Hoernchen20/picocell-gw/sketch.md

# Low-cost LoRaWAN gateway: WM1302 (SPI) + W5500-EVB-Pico2

Design sketch for a microcontroller-based LoRaWAN gateway that connects directly to
ChirpStack over MQTT/TLS with protobuf payloads. Firmware in Rust.

Status: concept. WM1302 mPCIe pinout verified against the Seeed WM1302 (SPI) EU868
datasheet (section 2.5); do not copy pin numbers from Seeed's Raspberry Pi
`reset_lgw.sh` scripts (known to be inconsistent, and they describe the Pi HAT, not
the module).

---

## 1. Goals and scope

- Class A uplink/downlink, Class C unicast and Class C multicast (scheduling type
  **Delay**). No Class B for now.
- EU868, single WM1302 SPI module (SX1302 + 2x SX1250), variant **without** the SX1262
  (LBT/spectral scan): LBT is not required in EU868 (ETSI duty cycle applies).
- Ethernet only (W5500). No PoE in the first board revision.
- Power: 24 V DC like an industrial PLC (IEC 61131-2 range 19.2–30 V), wide-input
  front end (9–32 V) so 12 V supplies also work. USB power alone runs the whole board
  (incl. WM1302) for provisioning on the desk.
- Direct connection to ChirpStack's MQTT broker, replacing what Concentratord +
  ChirpStack MQTT Forwarder do on a Linux gateway.
- MQTT authentication: per-gateway username/password, TLS with CA certificate only
  (no client certificate).

---

## 2. Hardware

### 2.1 Components

| Part | Purpose | Notes |
|---|---|---|
| W5500-EVB-Pico2 | MCU (RP2350, 520 KB SRAM, 2 MB flash) + Ethernet | GP16–GP21 are used internally for the W5500 |
| Seeed WM1302 SPI (EU868) | LoRa concentrator, mPCIe 52-pin | SX1302 reset is active HIGH on the SPI version |
| mPCIe socket + standoff/latch | Holds the WM1302 | 52-pin, 0.8 mm pitch |
| Wide-input buck 24 V → 5 V, ≥ 1.5 A | Primary supply (input 9–32 V) | TI LMR38020SDDAR (4.2–80 V, 85 V abs. max, 2 A, HSOIC-8, PFM + spread spectrum), 80 V for surge margin (see 2.4) |
| Input protection | Reverse polarity, surge, overcurrent | PTC 60 V + TVS SM8S33A (6600 W, DO-218AB) as crowbar + series Schottky 100 V, π-filter (see 2.4) |
| 5 V → 3.3 V buck, ≥ 1 A, with EN | Dedicated supply for the WM1302, switched by POWER_EN | TI TPS563201 (3 A, 4.5–17 V, EN with internal pull-down) |
| 5 V → 3.3 V LDO, high PSRR, fast discharge | Supply for the L76K | TI TLV75533PDBVR (500 mA, active output discharge); Quectel advises against a DC-DC here |
| Bulk + ceramic caps | TX current peaks | Limited by the TPS563201 (20–68 µF total output capacitance, see 2.4) |
| Power mux | 5 V from the 24 V buck (priority) or USB VBUS → 5V_SYS | TI TPS2116 (1.6–5.5 V, 2.5 A, 40 mΩ, reverse blocking, ST flag); replaces the VSYS Schottky (see 2.4) |
| ATECC608B (DNP footprint) | Future: mTLS private key in hardware | Same I2C bus as the WM1302 temp sensor, powered from the WM1302 3.3 V rail |
| Quectel L76K (DNP footprint) | Future: Class B / GPS time | GPS/BeiDou/GLONASS/QZSS, 2.7–3.4 V, ~29 mA, UART + 1PPS, U.FL for GNSS antenna |
| PPS buffer (DNP) | L76K 1PPS → WM1302 pin 19 without back-powering | SN74LVC1G17 (Schmitt buffer, I_off), powered from the WM1302 3.3 V rail |
| Status LED | One LED, states as blink patterns | GPIO-driven, visible from outside (light pipe) |
| Buttons | Provisioning (GPIO) and reset (Pico RUN) | Tactile switches |
| 24 V DC input | Pluggable screw terminal (5.08 mm), 3-pin: +24 V, 0 V, FE | USB-C on the Pico for console/flashing/desk power |

### 2.2 Block diagram (signals and power)

```mermaid
flowchart LR
    subgraph PWR["Power"]
        VIN["24 V DC input<br/>(3-pin terminal, FE)"]
        PROT["PTC + TVS (crowbar)<br/>+ Schottky + π-filter"]
        BUCK24["Buck 24V→5V<br/>≥2 A"]
        MUX["Power mux TPS2116<br/>VIN1 priority"]
        V5["5V_SYS rail"]
        BUCK["Buck 5V→3.3V<br/>≥1 A, EN<br/>+ bulk caps"]
        LDO["LDO 5V→3.3V<br/>(GNSS)"]
    end

    subgraph PICO["W5500-EVB-Pico2"]
        VSYS["VSYS"]
        VBUS["VBUS"]
        RUN["RUN"]
        RP["RP2350"]
        W5500["W5500<br/>(GP16–21 internal)"]
        USB["USB-C<br/>console / UF2"]
        RJ45["RJ45"]
    end

    PPSBUF["PPS buffer<br/>(DNP, WM1302 rail)"]
    LED["Status LED"]
    BTN["Provisioning button"]
    RST["Reset button"]

    subgraph WM["WM1302 SPI (mPCIe)"]
        V33["3V3 pins"]
        SX1302["SX1302<br/>+ 2× SX1250"]
        TEMP["Temp sensor (I2C)"]
        PPS["1PPS (pin 19)"]
    end

    ATECC["ATECC608B<br/>(DNP)"]
    GPS["Quectel L76K GNSS<br/>(DNP)"]
    ANT["LoRa antenna (U.FL)"]
    NET["LAN → MQTT broker<br/>(ChirpStack)"]

    VIN --> PROT --> BUCK24 -- "VIN1" --> MUX --> V5
    USB --> VBUS -- "VIN2" --> MUX
    MUX -- "ST" --> RP
    V5 --> BUCK --> V33
    V5 --> VSYS
    V5 --> LDO --> GPS

    RP -- "SPI1: SCK GP10 / MOSI GP11 / MISO GP12" --> SX1302
    RP -- "CS GP13" --> SX1302
    RP -- "SX1302_RESET GP14" --> SX1302
    RP -- "POWER_EN GP15 (buck EN)" --> BUCK
    RP -- "I2C0: SDA GP4 / SCL GP5" --> TEMP
    RP -- "I2C0" --> ATECC
    GPS -- "1PPS" --> PPSBUF --> PPS
    GPS -- "1PPS (GP2)" --> RP
    GPS -- "UART0: GP0/GP1" --> RP
    RP -- "GP28" --> LED
    BTN -- "GP22" --> RP
    RST --> RUN
    SX1302 --- ANT
    RP <--> W5500 --- RJ45 --- NET
    RP --- USB
```

Ground: single common ground between input, buck, Pico and mPCIe socket, tied to the
FE terminal (see 2.4).

### 2.3 Pin map

| Pico GPIO | Function | Peripheral pin |
|---|---|---|
| GP10 | SPI1 SCK | WM1302 pin 45 SPI_SCK |
| GP11 | SPI1 TX (MOSI) | WM1302 pin 49 SPI_MOSI |
| GP12 | SPI1 RX (MISO) | WM1302 pin 47 SPI_MISO |
| GP13 | CS SX1302 | WM1302 pin 51 SX1302_CSN |
| GP14 | SX1302_RESET (active high on SPI version), external pull-down | WM1302 pin 22 RESET |
| GP15 | POWER_EN | EN of the WM1302 3.3 V buck (external pull-down, module off at boot) |
| GP4 / GP5 | I2C0 SDA / SCL | WM1302 pins 32 / 30 (temp sensor), ATECC608B (DNP); 4.7 kΩ pull-ups to the WM1302 3.3 V rail |
| GP0 / GP1 | UART0 TX / RX | L76K pin 3 RXD / pin 2 TXD (DNP) |
| GP2 | PPS sense (input) | L76K pin 4 1PPS (DNP), taken before the PPS buffer |
| GP3 | L76K reset (open-drain: drive low or hi-Z) | L76K pin 9 RESET_N (DNP) |
| GP22 | Provisioning button (input, active low) | Switch to GND, 10 kΩ pull-up to 3V3, 100 nF |
| GP6–GP9 | — | Free |
| GP26 | — | Free (ADC0) |
| GP27 | Power source (input) | TPS2116 ST (open-drain, low = running on USB VBUS), 10 kΩ pull-up to 3V3 |
| GP28 | Status LED (output, active high) | LED + series resistor to GND |
| RUN | Reset button | Switch to GND (RUN has a pull-up on the Pico) |
| GP16–GP21 | — | W5500 (internal, do not use) |

SPI lines from the Pico (SCK, MOSI, CS) get 33 Ω series resistors at the Pico
side (edge damping, limits back-feed into the unpowered module). Pressing reset also
power-cycles the WM1302: GP15 goes hi-Z and the pull-down switches the buck off.

WM1302 mPCIe pins (SPI version, from the Seeed datasheet):

| mPCIe pin | WM1302 signal | Connect to |
|---|---|---|
| 2, 24, 39, 41, 52 | 3V3 | 3.3 V buck output (all five) |
| 4, 9, 15, 18, 21, 26, 27, 29, 34, 35, 37, 40, 43, 50 | GND | Ground plane |
| 19 | 1PPS (input) | L76K 1PPS through the DNP PPS buffer; 100 kΩ pull-down (fitted) so the pin does not float without GNSS |
| 14 / 16 | I2C_SCL / I2C_SDA (temp sensor, second pair) | NC (use 30/32) |
| 36 / 38 | USB_D− / USB_D+ | NC (USB version only) |
| 8, 10, 25, 31, 33 | SX1262 BUSY / RST / CSN / IO2 / IO1 | NC (SX1262 variant not used) |
| others | NC | NC |

The module has **no** power-enable pin; the `SX1302_POWER_EN` in Seeed's scripts
switches a regulator on the Pi HAT. On this board POWER_EN switches the 3.3 V buck.
L76K SET (pin 18) floating = GPS + BeiDou; WAKEUP, ANTON and RESERVED pins NC.

### 2.4 Power notes

- Input: 24 V DC nominal like an industrial PLC; design for 9–32 V continuous so
  IEC 61131-2 (19.2–30 V incl. ripple) and 12 V supplies are covered. Buck rated
  80 V, all parts before the buck (FET, PTC, filter, caps) rated ≥ 100 V.
- Input protection chain: terminal → PTC (60 V, 0.75 A hold) → TVS SM8S33A to GND
  → series Schottky SS210 (100 V, 2 A) → π-filter → LMR38020.
  - The TVS sits directly at the input, before any series element. A reverse-polarity
    blocker in front of a unidirectional TVS (P-FET, diode) would have to block the
    full negative surge (up to −500 V line-to-line), and a bidirectional TVS with the
    SM8S current rating does not exist in SMD.
  - Reverse polarity: the TVS conducts forward (crowbar, ~ −1 V) and the PTC trips;
    it resets once the wiring is fixed. The Schottky keeps the −1 V away from the
    buck (VIN abs. min −0.3 V). Negative surges are clamped the same way.
  - Series Schottky instead of a P-FET / ideal diode: input current is only
    ~0.12 A at 24 V (0.33 A at 9 V), so the drop costs < 0.1 W; one part instead of
    FET + zener + resistor.
  - PTC Imax 100 A covers the short-circuit current of typical 24 V cabinet supplies;
    hold current 0.75 A at 25 °C, ~0.5 A at 85 °C, above the 0.33 A worst case at 9 V.
  - π-filter for conducted EMC: 4.7 µF / 100 V ceramic, 4.7 µH, then 2× 22 µF / 100 V
    electrolytic + 4.7 µF ceramic + 100 nF at the buck. Resonance ≈ 33 kHz, well below
    f_SW = 400 kHz. The electrolytic on the buck side is **mandatory**, see surge
    check below.
- Surge target: EN IEC 61000-6-2:2019 (= IEC 61000-6-2:2016), Table 3 item 3.2,
  DC power port, IEC 61000-4-5, 1.2/50 (8/20) µs, criterion B: **±0.5 kV
  line-to-line, ±1 kV line-to-earth**. IEC 61000-4-5 source impedance on power
  ports: 2 Ω line-to-line (→ 250 A short circuit at 0.5 kV), 12 Ω (10 Ω + 2 Ω)
  line-to-earth (→ 84 A at 1 kV); ST AN4275 Table 2.
- Applicability (Table 3 notes, definitions 3.5, 3.6):
  - Surge only on ports "interfacing with long distance lines": > 30 m inside the
    building or leaving the building (note b). Not for removable/rechargeable
    batteries.
  - DC ports not intended for a "DC distribution network" (site supply for several
    devices; a link to one local battery is not one) are tested as signal ports
    (Table 2: ±1 kV line-to-earth only, 42 Ω, also only for long distance lines;
    no line-to-line test).
  - With a specified AC–DC adaptor the surge goes on the adaptor's AC input
    (notes d, f); not our case.
  - A 24 V cabinet supply feeding several devices counts as a DC distribution
    network, so the board is designed for the full Table 3 levels; with cables
    ≤ 30 m inside the building the test would not apply at all.
- Line-to-earth: the board GND reaches earth through the coax shields (grounded
  mast), the Ethernet shield and the FE terminal. On a +24 V-to-earth surge the
  current flows +24 V → TVS → GND → FE, at most 84 A, below the line-to-line case.
- Earth terminal: 3-pin input terminal +24 V / 0 V / FE. FE is a functional earth,
  not a protective earth (24 V SELV/PELV device, no protective function), so label
  it FE. GND is tied **directly** to FE with wide copper, no capacitor: a GND–FE
  capacitor (e.g. 4.7 nF) cannot carry the 84 A line-to-earth surge. Many cabinets
  earth the 24 V supply's 0 V anyway, so the direct link adds no new ground loop.
  - Miswiring +24 V onto FE shorts the supply across the board's 0 V–FE copper,
    bypassing the PTC. Put the pins in the order +24 V, 0 V, FE, use a coded plug,
    and size the 0 V–FE copper for the supply's short-circuit current until its
    current limit or fuse acts.
- Surge check result: line-to-line the generator source impedance is 2 Ω, so the
  TVS sees up to ~250 A (8/20 µs). SMCJ33A: 155 A at 8/20 µs (Littelfuse product
  page), so it **does not pass**. Its 53.3 V clamp is specified at only 28.2 A
  (10/1000 µs); at 8/20 µs surge currents the clamp is well above that. SM8S33A
  (6600 W, 53.3 V at 124 A 10/1000 µs) carries the current, but its clamp at ~250 A
  is likely at or above 60 V, which would leave a 60 V buck such as the LMR36015
  (60 V operating, 66 V abs. max) no margin.
- Decision: SM8S33A + TI LMR38020 (4.2–80 V, 2 A, HSOIC-8) instead of the LMR36015;
  all parts before the buck rated ≥ 100 V. Rejected: keeping the 60 V buck with a
  two-stage protection (primary TVS, series impedance, secondary TVS); more parts.
- SM8S33A clamp at the real surge current (estimate, Vishay gives only 10/1000 µs
  data): linear model V_C = V_BR + R_d · I with V_BR max 40.6 V and
  R_d = (53.3 − 36.7) V / 124 A = 0.134 Ω (conservative, from V_BR min). Simulated
  with the 0.5 kV / 2 Ω generator, IEC 8/20 short-circuit current, then Schottky,
  4.7 µH, 2 µF effective ceramic (4.7 µF / 100 V at DC bias) and the electrolytic
  (script: TVS + π-filter ODE, no PTC resistance, no wiring inductance; both
  would lower the peaks):

  | Case | I_TVS peak | V_TVS peak | V at LMR38020 VIN |
  |---|---|---|---|
  | 25 °C, 47 µF / 0.5 Ω electrolytic | 200 A | 67 V | 61 V |
  | 85 °C (V_BR +6 %), 2× 22 µF / 100 V | 197 A | 69 V | **63 V** |
  | 85 °C, **no electrolytic** | 213 A | 72 V | **99 V** (LC overshoot) |

  Result: TVS clamp ≤ 72 V, buck input ≤ 63 V with the electrolytic, i.e. 17 V
  below the 80 V operating and 22 V below the 85 V absolute maximum. Without the
  damping electrolytic the π-filter rings above 85 V, so it must be fitted on the
  buck side of the filter inductor and rated 100 V (not 63 V). Peak current through
  the Schottky and the filter inductor ≈ 46 A for some 10 µs (SS210 I_FSM 50 A at
  8.3 ms; the inductor saturates briefly, which lowers L and the overshoot).
  Pulse energy in the TVS ≈ 70 V · 200 A · ~20 µs ≈ 0.3 J, far below its rating.
- LMR38020 values (datasheet SNVSC40E, Table 9-1 and section 9.2.2), 24 V → 5 V,
  400 kHz:
  - f_SW 400 kHz: R_T = 64.9 kΩ (RT/SYNC must not float or be shorted). 2.2 MHz is
    not possible at 32 V in (t_ON = 71 ns < t_ON-MIN 80–131 ns).
  - FB: R_FBT 100 kΩ, R_FBB 24.9 kΩ (V_REF 1.0 V → 5.0 V).
  - L = 15 µH (Eq. 10 with K = 0.4 at 32 V: 13 µH), I_SAT ≥ 3.8 A
    (I_HS-LIMIT max): FCH0650-150M (5 A).
  - C_OUT 3× 22 µF / 25 V X5R 1206 (TI: 3× 22 µF nominal, 2× 22 µF minimum).
  - C_IN: 4.7 µF / 100 V X7R 1210 + 100 nF / 100 V 0603 at the VIN pin (single
    VIN pin, GND = pin 1 + thermal pad), C_BOOT 100 nF.
  - EN: UVLO divider R_ENB 100 kΩ, R_ENT 536 kΩ → on at 8.0 V, off at ~7.0 V
    (V_EN-H 1.25 V, V_EN-L 1.10 V); during a surge EN sees ≤ 11 V (abs. max
    V_IN + 0.3 V).
  - PG unused; route to a test point (the TPS2116 ST on GP27 already tells whether
    the 24 V path is up).
  - Layout: tight C_IN–VIN–GND loop, small SW node, FB divider at FB away from SW,
    thermal vias under the pad; 4-layer board with a solid inner GND plane. No
    snap-back (thyristor) TVS on the input (TI: output caps discharge back into it).
- TPS563201 (5 V → 3.3 V, WM1302), datasheet Table 7-2: R1 33.2 kΩ, R2 10 kΩ,
  L 2.2 µH, **total output capacitance 20–68 µF** (D-CAP2 stability). So no
  2× 100 µF bulk at the socket: 2× 22 µF at the buck + 22 µF + 100 nF at the
  mPCIe 3V3 pins (66 µF nominal, less with DC bias), plus a DNP footprint for a
  polymer bulk cap to try on the real board. EN has an internal 1.5 MΩ pull-down
  (module off while GP15 floats at boot); add 4.7 kΩ external (see RP2350-E9 below).
  Input 10 µF + 100 nF.
- RP2350-E9: on A2 silicon a Bank 0 GPIO with the input buffer enabled leaks and can
  float to ~2 V against a weak pull-down; the erratum asks for external pull-downs
  ≤ 8.2 kΩ. The A4 stepping fixes it, but the stepping on the W5500-EVB-Pico2 is not
  guaranteed, so POWER_EN (GP15) and SX1302_RESET (GP14) get 4.7 kΩ to GND
  (0.7 mA while driven high). Harmless on A4.
- 5V_SYS via power mux: TI TPS2116 in priority mode, VIN1 = LMR38020 output,
  VIN2 = Pico VBUS (pin 40), VOUT = 5V_SYS → Pico VSYS, TPS563201, TLV75533. PR1
  divider from VIN1 sets the switchover: V_REF 0.92–1.08 V (datasheet SLVSFG1A),
  33.2 kΩ / 10 kΩ → 4.32 V nominal, 3.97–4.67 V worst case, below the 5.0 V buck
  output. MODE tied to VIN1; without 24 V MODE is low and the mux passes the higher
  input (VBUS). 1 µF at VIN2, 22 µF at VOUT. The
  mux blocks reverse current, so 5V_SYS never feeds the USB host or the buck output,
  and the SS34 to VSYS is dropped; the Pico's internal VBUS → VSYS Schottky in
  parallel is harmless. A plain Schottky from VBUS would not work: VBUS min 4.75 V
  minus ~0.35 V is below the TPS563201's 4.5 V minimum input. ST (open-drain, low
  when VIN2 is used) → GP27, so firmware knows it runs on USB.
- USB budget: WM1302 max ~0.3 A at 5 V (TX 26 dBm) + Pico/W5500 ~0.15 A ≈ 0.45 A,
  just inside 500 mA. On USB power the firmware limits TX power (or does not
  transmit); provisioning and RX work normally.
- Rails from 5V_SYS: Pico VSYS, 5 V → 3.3 V buck for the WM1302 and 5 V → 3.3 V
  LDO for the L76K.
- Power domains and back-powering: the Pico 3V3 and the L76K LDO are always on,
  the WM1302 rail is switched. Everything that connects to the module is either
  driven by the Pico (kept low/input while the rail is off, 33 Ω series on SPI) or
  sits in the WM1302 domain: I2C pull-ups and the ATECC608B on the WM1302 rail (the
  ATECC is only usable while the module is on, fine since it is only off for a
  power-cycle), 1PPS through a DNP SN74LVC1G17 powered from the WM1302 rail (I_off:
  input and output high-Z while unpowered). Fit the buffer together with the L76K.
- Current budget at 5 V: WM1302 max 415 mA at 3.3 V (datasheet, TX 26 dBm) ≈ 0.3 A,
  Pico 2 + W5500 ≈ 0.15 A, L76K 29 mA. Total ≈ 0.5 A, so the 2 A 24 V → 5 V stage and
  a ≥ 1 A WM1302 buck leave good margin for start-up and TX transients.
- Do **not** power the WM1302 from the Pico's 3V3 pin; use the dedicated buck.
- Place the socket decoupling (22 µF + 100 nF) close to the mPCIe 3.3 V pins for TX peaks.
- Power sequencing: keep all Pico pins towards the WM1302 as inputs / low until the
  module's 3.3 V rail is up (avoid back-powering through I/O). POWER_EN (GP15) drives
  the buck's EN with a pull-down, which also gives a hard power-cycle of the module.
- Status LED on GP28 shows states as blink patterns (e.g. booting, no Ethernet, no
  broker, online, provisioning mode, error).

### 2.5 Parts for JLCPCB assembly

Checked against the JLCPCB parts library on 2026-10-17 (stock changes; re-check
before ordering). "Basic" parts have no extended-part setup fee. DNP parts are not
placed, so they need a footprint but no stock.

| Ref / function | Part | LCSC | Lib | Stock | Notes |
|---|---|---|---|---|---|
| 24 V input terminal | DEGSON 15EDGVC-5.08-03P-14-00AH (3-pin) | to check | ext | — | THT header, +24 V / 0 V / FE; plug 15EDGK-5.08-03P ordered separately (2-pin version was C23107080) |
| PTC | TECHFUSE SMD075L-60V (2920) | C2833621 | ext | 4.3k | 0.75 A hold / 1.5 A trip, 60 V, Imax 100 A |
| TVS | Vishay SM8S33AHE3_A/I (DO-218AB) | C335622 | ext | 4.5k | DOWO C312613 (9k) as second source |
| Series Schottky | MDD SS210 (SMA) | C14996 | basic | 787k | 100 V 2 A |
| π-filter inductor | Sunlord SWPA4030S4R7MT | C57269 | ext | 19k | 4.7 µH |
| 100 V ceramic | FH 1210B475K101NT (4.7 µF X7R 1210) | C2840282 | ext | 31k | 2× (filter in, buck VIN) |
| 100 V 100 nF | Samsung CL10B104KC8NNNC (0603) | C15725 | ext | 133k | at buck VIN |
| Damping electrolytic | Panasonic EEEFK2A220P (22 µF 100 V, D8×10.2) | C178570 | ext | 4.1k | 2× in parallel |
| 24 V → 5 V buck | TI LMR38020SDDAR | C3192337 | ext | 9.3k | |
| 15 µH inductor | FANGCHENG FCH0650-150M | C20415538 | ext | 8.4k | I_SAT 5 A |
| 22 µF 25 V 1206 | Samsung CL31A226KAHNNNE | C12891 | basic | 492k | 5 V out (3×), 3.3 V out |
| 5 V → 3.3 V buck | TI TPS563201DDCR | C116592 | ext | 112k | |
| 2.2 µH inductor | Sunlord SWPA4030S2R2MT | C36409 | ext | 37k | |
| Power mux | TI TPS2116DRLR (SOT-583) | to check | ext | — | VIN1 buck 5 V, VIN2 VBUS; replaces the SS34 |
| PPS buffer (DNP) | TI SN74LVC1G17DBVR (SOT-23-5) | to check | — | — | I_off, powered from the WM1302 rail |
| Status LED | 0603 LED, basic library | to check | basic | — | |
| Buttons | SMD tactile switch, basic library | to check | basic | — | 2× (provisioning, reset) |
| mPCIe socket | XUNPU PCIE-52P52H (5.2 mm) | C266899 | ext | 12k | SOFNG C444927 as second source |
| Module standoff | Würth 9774030243R (M2, 3.0 mm SMT) | C22431109 | ext | 725 | height to check against socket drawing |
| Pico headers | HCTL PM254-1-20-Z-8.5 (1×20 female) | C2897383 | ext | 4.2k | 2×, THT |
| L76K LDO (DNP) | TI TLV75533PDBVR | C404027 | ext | 117k | active discharge, VIN ≤ 5.5 V |
| GNSS (DNP) | Quectel L76KB-A58 | C2916234 | ext | 2.2k | |
| GNSS U.FL (DNP) | BAT WIRELESS BWU.FL-IPEX1 | C5137195 | ext | 595k | |
| GNSS bias L (DNP) | Murata LQG15HS68NJ02D (68 nH 0402) | C98000 | ext | 15k | |
| GNSS RF ESD (DNP) | Nexperia PESD5V0F1BL (0.4 pF) | C45961 | ext | 53k | |
| ATECC608B (DNP) | ATECC608B-SSHDA-T (SOIC-8) | C1518769 | ext | 921 | |
| V_BCKP supercap (DNP) | not stocked at JLCPCB, see section 6 | — | — | — | THT, hand-soldered |

Resistors and small caps (0402/0603) from the basic library. THT parts (terminal,
Pico headers, supercap) either via JLCPCB THT assembly or hand-soldered.
The WM1302 carries its own U.FL for the LoRa antenna; the board needs no LoRa RF
path.

---

## 3. Firmware architecture (Rust)

### 3.1 Stack

| Layer | Choice |
|---|---|
| Runtime / HAL | Embassy, `embassy-rp` (RP2350) |
| Ethernet / IP | `embassy-net-wiznet` (W5500 MACRAW) + `embassy-net` (smoltcp), static IPv4 (DHCP optional), see 3.4 |
| Name resolution | Own resolver: hosts table, then own DNS client over UDP (optional), see 3.4 |
| TLS | `embedded-tls` git `main` pinned to rev `6487c62` (TLS 1.3 only, **not** 0.19.0, see below), features `p256` + `rustpki`; crypto via `embassy-crypto` (git) with `embassy-crypto-rustcrypto`, own RNG driver on the RP2350 TRNG; fail-closed clock wrapper around the verifier |
| MQTT | `rust-mqtt` 0.6 (MQTT 5, no_std, no alloc with `bump` feature) |
| Protobuf | `micropb` (no alloc, heapless containers), generated from ChirpStack `api/proto/gw/gw.proto` + `common.proto` |
| Concentrator | Semtech `sx1302_hal` (C) built via `cc`, with a Rust shim for SPI/I2C/delays. Later optionally ported to Rust |
| Config storage | `sequential-storage` KV in a flash partition, AES-GCM encrypted |
| Bootloader / OTA | RP2350 boot ROM: secure boot + partition table A/B + TBYB, no second-stage bootloader |

Reference implementations: ChirpStack Concentratord and ChirpStack MQTT Forwarder
(both Rust, Linux).

Decisions and reasons:

- **TLS (`embedded-tls`)**: TLS 1.3 only, so the broker must offer TLS 1.3
  (Mosquitto with OpenSSL ≥ 1.1.1 does). The broker certificate uses an
  **ECDSA P-256** key: RSA verification needs the `rsa` crate and a global
  allocator, P-256 does not. RP2350 has a SHA-256 accelerator and TRNG; AES-GCM and
  P-256 run in software (handshake time still to be measured on the RP2350).
  - **Do not use the 0.19.0 release** (checked 2026-10-23): it accepts a server
    `Finished` without `Certificate` / `CertificateVerify`, so an on-path attacker
    completes the handshake with any verifier (upstream issue #215, fixed on `main`
    2026-10-20, not released). Its async record read is also not cancel-safe
    (partial record header lost when a `select!` drops the read, fixed on `main`
    2026-09-09). Pin `main` to a reviewed rev until a release after 0.19.0 exists.
  - Verifier on `main`: `rustpki` (`pki::CertVerifier`) accepts **only a broker
    certificate signed directly by the trusted root** and ignores the rest of the
    chain (a chain through an intermediate needs the `webpki` verifier). So: a
    dedicated P-256 root CA for the broker only, signing the broker certificate
    directly, no intermediate. This also removes the old `basicConstraints` problem
    (0.19.0 accepted a chain signed by an ordinary CA:FALSE leaf) and the
    chain-pinning wrapper. `webpki` on `main` now builds no_std via
    `rustls-webpki` 0.103 + `embassy-crypto` but is not needed.
  - Checks: validity dates, signature by the root, hostname via SAN/CN (max. 3 SANs
    of 64 chars), `CertificateVerify`.
  - If the clock is unknown (`TlsClock::now()` returns `None`), `rustpki` skips the
    validity check; a small wrapper verifier rejects in that case (fail closed, see
    section 6).
  - Crypto on `main` goes through `embassy-crypto` drivers resolved at link time:
    `embassy-crypto-rustcrypto` (SHA-256, HMAC, AES-128-GCM, P-256) plus an RNG
    driver. Released `embassy-rp` 0.10 has no `embassy-crypto-rng` feature (git
    `main` has it), so the firmware registers its own ~15-line driver on the TRNG
    (`embassy_crypto::rng_impl!`). Keep the rest of Embassy on the crates.io
    releases: Embassy git `main` replaced smoltcp in `embassy-net` with a new stack.
  - Record buffers: read buffer 16640 B (one full TLS record), write buffer 4352 B
    (records the device sends are split to fit). `max_fragment_length` (4096) with
    a 4352 B read buffer also works with OpenSSL/Mosquitto, but depends on the
    broker (or a TLS proxy in front of it) honouring the extension; RAM is not
    tight, so the full-size read buffer is used instead. Size: `TlsConnection`
    0.6 KB + verifier (`CERT_SIZE` 2048) 2.6 KB + buffers 20.5 KB ≈ 24 KB.
- **MQTT (`rust-mqtt` 0.6)**: `rumqttc` rejected (needs `std` + `tokio`).
  `rust-mqtt` is MQTT 5 only (fine with Mosquitto ≥ 1.6), uses `embedded-io-async`
  0.7 like `embedded-tls` and `embassy-net` 0.9, and needs no allocator with the
  `bump` feature. Tested 2026-10-23 on the host against Mosquitto 2.0.11 (TLS 1.3,
  P-256 root → broker certificate, password file, ACL from 4.1), all passed:
  - Refused: unknown CA, wrong hostname, unknown time (fail closed), wrong password
    (`NotAuthorized`).
  - Retained `state/conn` ONLINE (QoS 1) and a retained Last Will OFFLINE, which the
    broker publishes when the TCP connection drops without DISCONNECT.
  - Subscribe `command/down` QoS 1; 1 KB and 10 KB downlinks received intact; a
    20 KB downlink above the client's `maximum_packet_size` (12 KB) is not
    delivered by the broker.
  - Uplinks QoS 0 / 1 with PUBACK; publishing to another gateway's topic is
    refused by the ACL (PUBACK `NotAuthorized`).
  - Full duplex in one task: `select!` of `poll_header()` against queued uplinks
    and a ping ticker. 300 × 1.5 KB downlinks during 236 uplinks; with a transport
    that returns 1–3 bytes per read, so most cancellations hit mid-record. With the
    record-header fix removed (0.19.0 behaviour) the same test breaks the
    connection on the first cancelled read.
  - Usage rules from this: only `poll_header()` is cancel-safe, so select on it and
    then run `poll_body()` to completion; never wrap `poll()` in a timeout, use the
    TCP socket timeout instead. Keepalive pings are the application's job.
    `BumpBuffer` needs an `unsafe` `reset()` after each event is dropped. One topic
    per SUBSCRIBE. `abort()` refuses on a healthy connection; drop the transport
    or `disconnect()` instead.
  - Cross-build for the RP2350 (`embassy-rp` 0.10, `embassy-net-wiznet` 0.3,
    `embassy-net` 0.9.1, TLS, MQTT, own TRNG driver, defmt, `opt-level = "s"`,
    LTO): `.text` + `.rodata` 215 KB, `.bss` 68 KB including 25 KB of TCP/TLS/MQTT
    buffers (before the full-size TLS read buffer, +12 KB).
- **Protobuf (`micropb`)**: no allocator in the whole firmware, bounded memory per
  message. `prost` would need `alloc` only for this; rejected. Generation tested
  with `micropb-gen` 0.6 + vendored `protoc` (`protoc-bin-vendored`, no system
  install):
  - Builds no_std for `thumbv8m.main-none-eabihf`. Interop checked both ways: a
    `DownlinkFrame` encoded by `protoc` decodes correctly (2 items, LoRa modulation,
    delay timing), and an `UplinkFrame` encoded by micropb decodes cleanly with
    `protoc --decode`.
  - Needed: `retain_enum_prefix(true)` (prefix stripping panics on one of the
    ChirpStack enums), compile `timestamp.proto` + `duration.proto` but not
    `struct.proto` (recursive `Value`, imported but unused by gw.proto).
  - Capacities: default 32 B for string/bytes and 4 for repeated/map;
    `phy_payload` 256 B, `context` 16 B, stats per-frequency/per-status maps 16
    (heapless `FnvIndexMap` needs a power of two), per-modulation lists 8,
    `GatewayConfiguration.channels` 16, `DownlinkFrame.items` 4. Deprecated
    `*_legacy` fields skipped; the decoder ignores them on the wire.
  - Resulting struct sizes (host): `UplinkFrame` 920 B, `DownlinkFrame` 1.7 KB,
    `GatewayStats` 3.4 KB, `GatewayConfiguration` 1.3 KB, `DownlinkTxAck` 72 B.
  - Over MQTT only `UplinkFrame`, `GatewayStats`, `DownlinkTxAck`, `ConnState`
    (out) and `DownlinkFrame`, `GatewayConfiguration` (in) are used; `Event` /
    `Command` are the Concentratord ZMQ wrappers.
- **OTA (boot ROM A/B)**: secure boot is already planned with the key hash in OTP,
  so the boot ROM verifies the signature. Two partitions in the partition table,
  the new image is written to the inactive one and booted as TBYB ("try before you
  buy"); the firmware calls `explicit_buy` only after a successful broker
  connection, otherwise the watchdog reboot falls back to the old slot. Address
  translation maps either slot to the same XIP address, so one binary fits both.
  `embassy-boot-rp` would add a second bootloader and a second signing scheme on
  top of the ROM; rejected.
  `embassy-rp` 0.10 support (checked in the source):
  - `rom_data` binds everything needed: `explicit_buy`, `get_b_partition`,
    `pick_ab_parition`, `get_partition_table_info`, `flash_op`, `reboot`,
    `flash_runtime_to_storage_addr`. `block.rs` builds IMAGE_DEF and partition
    table blocks.
  - `ImageDef` has no TBYB builder, but the flag works by hand:
    `ImageDef::new([item_image_type_exe(Security::Secure, Architecture::Arm) |
    ((IMAGE_TYPE_TBYB as u32) << 16)])` (compiles together with the
    `explicit_buy` call).
  - `Flash::blocking_erase` / `blocking_write` take physical offsets (ROM
    `flash_range_*`), so writing the inactive slot and the config partition works.
    `Flash::blocking_read` reads through XIP at `0x10000000 + offset`, which the
    ROM's address translation maps to the running slot, so it does **not** read
    physical offsets. Read the inactive slot and the config partition with ROM
    `flash_op` (or an extra translation window); wrap that as an
    `embedded-storage` driver for `sequential-storage`. Verify on hardware.
  - After writing the new image: `reboot` with the FLASH_UPDATE type and the slot
    address (define the flag constant ourselves; embassy-rp only has BOOTSEL).
  - Partition table (2 MB flash, 4 KB sectors), created with picotool:

    | Range | Size | Use |
    |---|---|---|
    | `0x000000–0x001FFF` | 8 KB | partition table (unpartitioned) |
    | `0x002000–0x0F8FFF` | 988 KB | slot A (exe) |
    | `0x0F9000–0x1EFFFF` | 988 KB | slot B (exe, linked to A) |
    | `0x1F0000–0x1FFFFF` | 64 KB | config (`sequential-storage` KV, CA slots), no execute |

    Firmware linked at `0x10000000` with FLASH length 988 KB.

### 3.2 Tasks

```mermaid
flowchart TB
    RX["Concentrator RX task<br/>poll SX1302 ~10 ms"] -->|UplinkFrame| MQ["MQTT task<br/>TLS session, pub/sub"]
    MQ -->|DownlinkFrame| JIT["JIT downlink queue<br/>count_us scheduling"]
    JIT -->|lgw_send| CONC["SX1302 HAL"]
    CONC --> RX
    JIT -->|DownlinkTxAck| MQ
    ST["Stats task"] -->|GatewayStats| MQ
    TIME["SNTP task<br/>3 servers"] --> MQ
    CON["USB-CDC console<br/>provisioning"] --> CFG["Config store<br/>(encrypted flash)"]
    CFG --> MQ
    CFG --> CONC
    WD["Watchdog"]
```

The concentrator (sx1302_hal, blocking) runs on core 1, network/TLS and console on
core 0. Flash writes (config, OTA) park core 1 in RAM while XIP is off.

### 3.3 ChirpStack MQTT protocol

Topic prefix e.g. `eu868`, gateway ID = SX1302 EUI (hex).

| Direction | Topic | Message |
|---|---|---|
| publish | `eu868/gateway/<id>/event/up` | `UplinkFrame` |
| publish | `eu868/gateway/<id>/event/stats` | `GatewayStats` (include config/cert metadata) |
| publish | `eu868/gateway/<id>/event/ack` | `DownlinkTxAck` |
| publish (retained) | `eu868/gateway/<id>/state/conn` | `ConnState` ONLINE; Last Will = OFFLINE |
| subscribe | `eu868/gateway/<id>/command/down` | `DownlinkFrame`; retained ones ignored |
| subscribe | `eu868/gateway/<id>/command/config` | optional, gateway configuration |
| subscribe | `eu868/gateway/<id>/command/credentials` | new password, raw text (5.2); not ChirpStack |
| publish | `eu868/gateway/<id>/state/credentials` | `stored` / `committed` / `rejected: ...` (5.2) |

Downlink timing support:

- **Delay** (Class A): uplink `context` carries the SX1302 1 MHz counter value;
  TX at `count_us + delay`.
- **Immediately** (Class C unicast and Class C multicast with scheduling type Delay).
- **GPS epoch**: not supported until a GPS is fitted (reject with proper ack status).

JIT queue must reject collisions and too-late frames and report the matching
`DownlinkTxAck` status. Track airtime per sub-band and enforce EU868 duty cycle
(important for RX2 869.525 MHz / FUOTA bursts), ack with `DUTY_CYCLE_OVERFLOW`.

### 3.4 Network configuration and name resolution

Target networks have no DHCP and no DNS server, so the network is configured
statically and broker/NTP names are resolved like with `/etc/hosts` on Linux.

- **IP config**: `net.mode = static` (default) with address/prefix, default
  gateway and DNS servers from the config store (`embassy_net::Config::ipv4_static`).
  `net.mode = dhcp` is kept as an option (embassy-net `dhcpv4`, little extra code).
  If static config is missing or invalid, stay offline and signal it on the LED;
  provisioning works over USB without a network.
- **MAC address**: the W5500-EVB-Pico2 has no unique MAC and the board has no MAC
  EEPROM (dropped for v1: config lives encrypted in flash, rare writes, an external
EEPROM adds no security and I2C0 is on the switched WM1302 rail). Derive a locally
  administered unicast MAC from the RP2350 unique chip ID: hash the ID, take 6 bytes,
  set bit 1 and clear bit 0 of the first byte (`x2:xx:xx:xx:xx:xx`). Stable per Pico,
  changes if the Pico module is swapped. Optional `net.mac` override in the config.
- **Keep hostnames for TLS**: `mqtt.host` stays a hostname, because TLS uses it for
  SNI and the certificate hostname check. A bare IP only works if the broker
  certificate has an IP SAN. The hosts table overrides only the address lookup.
- **Resolver order** (like `hosts: files dns`), used by the MQTT and SNTP tasks:
  1. IP literal: the string parses as IPv4, use it directly.
  2. Hosts table: case-insensitive exact match, trailing dot ignored.
  3. DNS, only if servers are configured: servers in order, ~2 s timeout,
     2 tries each.
  4. Last known address: if DNS fails, reuse the last successful result (RAM).
  No match → error, MQTT reconnect backoff, LED pattern "no broker".
- **DNS client**: small own A-record client over an `embassy-net` `UdpSocket`
  (build query, parse answer, honour TTL), no allocation, host-testable. Not the
  smoltcp `DnsSocket`: its server list comes from the IP config (overwritten by
  DHCP, one server by default), which makes ordered static + DHCP servers awkward.
  In DHCP mode, DHCP-provided servers are tried after the static ones.

---

## 4. Security

### 4.1 MQTT authentication

- TLS 1.3 to the broker; device verifies the broker certificate against a stored CA
  and checks the hostname (SNI). Mosquitto must allow TLS 1.3.
- Dedicated P-256 root CA for the broker certificate only, signing it directly (no
  intermediate: the `rustpki` verifier only accepts a root-signed broker
  certificate, see 3.1, TLS). The broker certificate has ≤ 3 SANs.
- Per-gateway username (= gateway ID) and unique password.
- Mosquitto ACL (dynamic-security plugin or acl_file), least privilege:

```
pattern write eu868/gateway/%u/event/#
pattern write eu868/gateway/%u/state/#
pattern read  eu868/gateway/%u/command/#
```

A compromised gateway only exposes its own topics; revoke a single user.

### 4.2 Credential storage on the RP2350

- Secure boot enabled (public key hash in OTP), SWD disabled via OTP.
- Random per-device AES key in an OTP page; firmware reads it at boot and soft-locks
  the page until reset.
- Config blob (credentials, broker, channel plan) encrypted with AES-GCM in flash.
- CA certificate needs integrity, not secrecy: compiled into the signed image and/or
  stored as signed config.
- Limitation: physical attacker with fault-injection equipment may still extract
  secrets. Acceptable for this threat model.

### 4.3 ATECC608B (future)

Not useful for passwords (the MCU must have the password in clear text to send it).
Becomes useful when moving to mTLS: key generated inside the chip, CSR signed by the
same CA used by ChirpStack/Mosquitto, signing routed from `embedded-tls` to the chip.
Keep a DNP footprint on the PCB.

---

## 5. Updates and lifecycle

### 5.1 Firmware

- Every image signed with `picotool seal --sign` (boot ROM, secp256k1 + SHA-256);
  signing key kept offline.
- OTA via boot ROM A/B partitions (988 KB each in 2 MB flash, 64 KB config, see 3.1),
  TBYB boot, `explicit_buy` only after successful broker connection, otherwise
  roll back (see 3.1). The image arrives in chunks over MQTT on `command/ota`, see
  8.1 (8b).
- Anti-rollback version in OTP; up to four boot keys allow key rotation.
- USB BOOTSEL/UF2 stays enabled as recovery path (only signed images boot).

### 5.2 Username / password change

- Locally via USB console (optionally PIN / button).
- Remotely via a command topic (only ChirpStack/admin may publish to `command/`).
- Two-phase: store new alongside old → reconnect with new → commit on success,
  fall back on failure.
- Implemented: raw password on `command/credentials` (retained ones refused), same
  rule as the console (1–64 printable ASCII, no blanks, so no trimming or stray
  newline changes it unnoticed); staged as map item 2; answers on
  `state/credentials`; the next connection uses it (Mosquitto disconnects the
  gateway when the password file changes on reload, so the broker switches after
  `stored`). Attempts alternate new/stored on "bad username or password"; the
  accepted one wins (new: stored as `mqtt.password`, restart; stored: new dropped).

### 5.3 CA certificate rotation

- Trust store with multiple slots ("current" + "next"); roll out new CA long before
  switching the broker. Each slot holds one root that signs the broker
  certificate directly.
- New CA only via signed firmware or signed config message, never accepted unsigned
  over MQTT. Config messages are signed with a separate P-256 key, see 8.1 (8e,
  implemented).
- If the CA expired before rotation: USB recovery.

### 5.4 Recovery

- If the OTP key or config is lost/corrupt, device boots into provisioning mode;
  re-provision via USB console. Build and test this path from day one.

### 5.5 Console login

- Implemented (`fw/src/login.rs`): `console.password` in the encrypted config as
  PBKDF2-HMAC-SHA256 (10000 iterations, 0.5 s on the RP2350; random salt), required in
  production builds. While stored, the console allows only `help`, `status`, `log`,
  `login`, `logout` and `erase` before `login`; logout on port close, `logout` and
  10 minutes idle. Wrong passwords wait 3 s doubling to 60 s (counter in RAM).
- Forgotten password: `erase` without login. It deletes the MQTT password with the
  rest, so it gives nothing away; it only takes the gateway offline, which physical
  access allows anyway.
- `tools/provision.py` hashes the password on the host and logs in on a locked
  console; `tools/hil-test.py` provisions a test password and checks the lock.

---

## 6. Time

- Class A and Class C need no GPS/PPS: downlinks use the SX1302 counter or
  "immediately".
- SNTP client with three servers (discard outlier) for TLS validity checks, logs and
  approximate UTC on uplinks (correlate SX1302 counter with RP2350 timer in software).
- A PIO-generated PPS from NTP gives no benefit (accuracy limited by NTP over
  W5500/SPI, ~0.1–several ms, far from Class B requirements).
- Optional Quectel L76K footprint (1PPS → WM1302 GPS_PPS, UART → Pico) for future
  Class B, GPS-time multicast and time without network. Needs sky view.
- L76K notes (Quectel L76K Hardware Design V1.0):
  - VCC 2.7–3.4 V from its own LDO (high PSRR, fast discharge, supply ≥ 100 mA),
    ripple < 100 mV, rise < 40 ms; TVS + 10 µF / 100 nF / 33 pF at the pin. Quectel
    advises against a switching supply, so not from the Pico 3V3 rail.
  - V_BCKP must come up at the same time as or before VCC. Without it every start is
    a cold start (~30 s TTFF instead of 2 s). Decision: supercap on V_BCKP, charged
    from the L76K LDO output via diode + 1 kΩ (Quectel reference circuit). No
    battery to replace; bridges short power cuts. DNP 0 Ω to VCC as fallback.
  - Supercap sizing (L76K Hardware Design V1.0): V_BCKP 1.4–3.6 V (abs. max 3.6 V),
    backup mode 8 µA; 4.7 µF + 100 nF + 33 pF at the pin. Charged to ~3.0 V
    (3.3 V minus Schottky drop), usable ΔV = 3.0 − 1.4 = 1.6 V. Hold time
    t = C · ΔV / I: 0.22 F → ~12 h, **0.47 F → ~26 h** (minus the supercap's own
    leakage). Choice: 0.47 F, rated ≥ 3.3 V, leakage ≤ 2 µA; check the leakage in the
    part's datasheet because it is in the same range as the 8 µA load. Charging
    through 1 kΩ: τ = 470 s, ~25 min to full; initial 3 mA from the LDO is fine.
    Measure the real backup current on the board.
  - Part: JLCPCB stocks no 0.47 F supercap and no reflow-capable backup cell (MS621FE,
    ML414 out of stock); most supercaps are not reflow-rated anyway. Since the whole
    GNSS block is DNP, the supercap is a THT part hand-soldered together with the
    L76K. Candidate: Eaton PHVL-3R9H474-R (0.47 F, 3.9 V rated, radial, "low
    leakage" for RTC backup, −40…+65 °C); leakage figure still to be read from the
    datasheet. Alternative KEMET FGH0V474ZF (3.5 V).
  - I/O level = VCC (3.3 V), connects directly to the RP2350. UART 9600–115200 baud,
    no flow control; default rate depends on firmware version (Waveshare documents
    9600). Firmware probes 9600 then 115200 until valid NMEA arrives, then
    sets the rate with `$PCAS01`. Configuration via `$PCAS` sentences (no PMTK).
  - 1PPS: rising edge, 100 ms pulse, < 30 ns (1σ). Goes to WM1302 pin 19 and GP2.
  - RESET_N active low, ≥ 100 ms, internal pull-up; no external pull-up allowed, so
    drive it open-drain (OC transistor or GPIO switched between low and input).
  - Active antenna: powered from VDD_RF (= VCC) through 68 nH + 0 Ω into RF_IN, DC
    block 100 pF, ESD diode at the connector, π-match footprint (0 Ω, 2× NM).
    Antenna total gain < 17 dB, NF < 1.5 dB. Passive antenna only if cable < 1 m.
- Time sync failure: fail closed. The certificate check must fail when the time is
  unknown, so the MQTT task waits for a valid SNTP result before connecting, and the
  verifier wrapper (see 3.1) rejects the chain when `TlsClock::now()` returns `None`
  (`rustpki` would otherwise skip the validity check). No SNTP → no broker
  connection, LED pattern "no broker"; uplinks are not buffered meanwhile. SNTP is
  UDP and does not depend on TLS, so there is no circular dependency.

---

## 7. Provisioned configuration

| Key | Example | Notes |
|---|---|---|
| `gateway_id` | read from SX1302 EUI | Read-only, register in ChirpStack |
| `net.mode` | `static` | `static` (default) or `dhcp`, see 3.4 |
| `net.ipv4` | `10.0.0.20/24` | Address + prefix length (static mode) |
| `net.gateway` | `10.0.0.1` | Default gateway, optional (broker in same subnet) |
| `net.dns.servers[0..2]` | `10.0.0.1` | Optional; empty = hosts table only |
| `net.hosts[0..3]` | `mqtt.example.org` → `10.0.0.5` | Name (≤ 63 chars) + IPv4, checked before DNS |
| `net.mac` | derived from RP2350 chip ID | Optional override |
| `mqtt.host` / `mqtt.port` | `mqtt.example.org` / 8883 | Hostname, used for SNI + cert check (see 3.4) |
| `mqtt.topic_prefix` | `eu868` | |
| `mqtt.username` / `mqtt.password` | gateway ID / random | Encrypted |
| `console.password` | PBKDF2 hash | Console login, see 5.5 |
| `tls.ca[0..1]` | DER | Current + next CA |
| `ntp.servers` | 3 entries | IP or hostname (resolved via hosts table / DNS) |
| `radio.region` / channel plan | EU868 8+1+1 | Radio centre freqs, IF offsets |
| `radio.rssi_offset`, TX gain LUT | from WM1302 reference config | Board-specific |
| `radio.antenna_gain` | dBi | For EIRP limits |
| `location` | lat/lon/alt | Static, reported in stats |

---

## 8. Roadmap

1. Connector PCB: 24 V input stage, USB power mux, mPCIe socket, bucks, pin map,
   LED and buttons, DNP footprints (L76K, PPS buffer, ATECC608B).
2. Bring-up: SPI to SX1302, read chip version and EUI from Rust.
3. `sx1302_hal` via `cc` + shim; receive uplinks, print to USB console.
4. Ethernet (static IP, derived MAC) + resolver (hosts, DNS) + SNTP + TLS + MQTT; publish `UplinkFrame`, `ConnState`, `GatewayStats`.
5. JIT queue: Class A delay downlinks + `DownlinkTxAck`.
6. Class C unicast + Class C multicast (Delay), duty-cycle tracking; FUOTA test.
7. Config store + encryption, USB provisioning, remote credential change.
8. Secure boot, OTP key, signed A/B OTA, CA rotation (plan in 8.1).

### 8.1 Step 8 plan

Done one milestone at a time; each one is testable on its own. Starting point
(2026-10-25): the image has no IMAGE_DEF of its own (embassy-rp's default block:
unsigned, no TBYB, no rollback version), no partition table, no watchdog; config
reads go through XIP; the config key is HMAC(chip ID); `picotool` is not installed
(`tools/elf2uf2-rp2350.py` stands in for it); `tls.ca0`/`tls.ca1` with fallback to
the other slot after a failed handshake exist.

Ground rule: **no board gets locked.** There are only two boards, and both stay
dev boards: no OTP write on them, ever. Secure boot with a test key would not
brick a board, but it is permanent (only images signed with that key boot from then
on), so the steps marked "lock board" wait for a third board bought for that
purpose. Everything else runs on unlocked boards.

Dev and production build:

| | Dev (default `cargo run`) | Production (`--features production`) |
|---|---|---|
| Image | unsigned, hash only | `picotool seal --sign` |
| Config key | HMAC(chip ID), as now | random AES-128 key in OTP |
| OTP writes | none, the code is compiled out | only the AES key page, only via an explicit console command |
| SWD | untouched | disabled in OTP by the lock procedure (last step) |
| Console | full access | full access (password protection: see 9.1) |

- Boot key hash, CRIT flags and debug disable are written from the host with
  `picotool otp` in a separate lock procedure, never by the firmware. The firmware
  only writes the AES key, generated on the device from the TRNG; it never leaves
  the device.
- Production firmware creates the AES key only when secure boot is already on
  (otherwise unsigned code could read it).
- A production build stays offline (console only, no MQTT) unless the board is
  locked: secure boot on, a boot key that is not revoked, debug disabled
  (`DEBUG_DISABLE`; secure debug disable alone leaves the SRAM to a non-secure
  debugger). Otherwise a debugger or an unsigned image could read the config key and
  the MQTT password. Provisioning works before the last lock step, the gateway goes
  online after it. `fw/src/boot.rs` `refuse_online()`; `status` names the missing
  step. Lock board tests that need the broker with SWD still on use a signed dev
  build.
- `status` and the `GatewayStats` metadata show `dev`/`prod` and, read from OTP at
  runtime, whether secure boot, the OTP key and SWD disable are set.

Milestones:

- **8a. Partition table and flash driver** (dev boards, reversible)
  - Install `picotool`; partition table from 3.1 as JSON in the repo.
  - Own IMAGE_DEF: secure exe, TBYB flag, rollback version from `Cargo.toml`.
  - `flash_op`-based `embedded-storage` read driver for the config partition and
    the inactive slot (see 3.1); the config store moves to it.
  - On hardware: config still loads; UF2 drag-and-drop with the table works; find
    out which slot the ROM writes a UF2 to. Extend `tools/hil-test.py`.
  - Status (2026-10-25): done, tested on one board (`tools/hil-test.py` 15/15, remote
    password change there and back). `fw/partition-table.json` (config partition:
    secure rw only, no UF2 family, no bootloader access). IMAGE_DEF in
    `fw/src/boot.rs` (embassy-rp `imagedef-none`): secure exe + TBYB. The runner
    seals with `picotool seal --hash --major --minor` (version from `Cargo.toml`); no
    rollback version in dev builds, in case a buy with one writes the OTP rollback
    rows. Until 8b the firmware calls `explicit_buy` at boot when the ROM reports a
    buy pending; the ROM clears the flag in the last (hash) block and the hash still
    verifies. `fw/src/flash.rs`: read, erase and program via `flash_op` (storage
    address space, secure, XIP-based addresses), in a critical section; the config
    store uses it. `status` shows the ROM's boot info.
  - Findings: the table has to be loaded with `picotool load`; a `pt.uf2` copied
    to the BOOTSEL drive is ignored (no reboot, nothing written). With the table a
    UF2 copy goes to the slot that is not running (first copy B, then A, B, ...).
    A trial boot reports buy pending (0x01) and survives the 16.7 s watchdog once
    bought. Still open for 8b: a trial that is not bought falls back.
- **8b. A/B OTA with TBYB** (dev boards, unsigned images with hash)
  - Transport: chunks over MQTT. `command/ota` first gets a header (size, SHA-256,
    rollback version), then chunks with an offset (≤ 8 KB, below the 12 KB packet
    limit); the gateway answers on `state/ota` (progress, error, done). The ACL
    already restricts `command/#` to admin. Retained messages refused, as for
    `command/credentials`.
  - Write the inactive slot, check the SHA-256, `reboot` with FLASH_UPDATE.
  - `explicit_buy` after the first successful broker connection. The firmware takes
    over the watchdog (settles the watchdog point in 9.1) and has its own buy
    deadline (~5 min); missed → reboot → ROM boots the old slot. Check on hardware:
    the ROM's 16.7 s TBYB watchdog against DHCP + SNTP + TLS time, and that any
    reboot before the buy falls back.
  - Host tool `tools/ota-push.py`.
  - Tests: good update, truncated image, wrong SHA-256, image that never connects
    (roll back), reboot during the transfer.
  - Status (2026-10-25): implemented, tested on one board: `tools/hil-test.py --ota
    --ota-fallback` (wrong SHA-256 and truncated image refused without a restart;
    update into the other slot, bought after the broker connection, kept after a
    reboot; a trial locked out of the broker falls back on a reboot and after the
    300 s deadline), plus a reboot during the transfer by hand (old image runs on,
    the sender gets `error: no transfer`). `fw/src/ota.rs`:
    begin `0x01` + size + SHA-256, chunks `0x02` + offset + 4 KB (sector-aligned, in
    order; any other offset is answered with `next <offset>`, so the sender only
    resends on a timeout). The slot's first sector is erased at the begin and written
    last, after the SHA-256 matched (first sector from RAM, the rest read back), so a
    partial image never has a valid block loop. Reboot via ROM `reboot` FLASH_UPDATE
    with the slot's XIP address. Rollback version left out of the header: the ROM
    checks the one in the image (8c); an unsigned copy in the header adds nothing.
    `fw/src/boot.rs`: an OTA reboot leaves a mark in watchdog SCRATCH0 (the ROM uses
    2–7); with it a trial is bought after connect + subscribe, so the new image can
    take the next update. Without it (UF2 copy, someone at the USB port) the trial
    is bought at boot, as in 8a, so provisioning mode and broker-less dev work keep
    their image. Watchdog 8 s, fed every second by `boot::watchdog_task`, which also
    replaces the ROM's 16.7 s; buy deadline 300 s, then reset. An update is refused
    while the image is still on trial (the other slot is its fallback).
    `tools/ota-push.py` (standard library MQTT 3.1.1 client, QoS 1, 4 KB chunks).
  - Findings: `explicit_buy` erases the first sector of the other slot (tbyb/update
    0x04 afterwards), so there is no going back to the previous image once bought;
    a normal boot never picks an unbought TBYB image (datasheet 5.1.17), so any
    reboot before the buy falls back. DHCP took 12 s and the broker connection came
    after 13.5 s: within the ROM's 16.7 s, but too close to rely on it. 330 KB take
    about 8 s. A reset in the 200 ms between `verified` and the OTA reboot is a
    normal boot, which skips the unbought new image: the update is lost, the old
    image runs on (safe; `ota-push.py` exits 0 then, the slot in `status` tells).
- **8c. Signing**
  - secp256k1 test signing key, committed as dev material; the production key is
    separate and kept offline.
  - Production runner wraps `picotool seal --sign`; check the signature on the
    host (script against the public key) so the tooling is tested without OTP.
  - Lock board only: test key hash into BOOTKEY0, then `SECURE_BOOT_ENABLE`, SWD
    stays on. Tests: unsigned UF2 refused, signed boots, OTA with a bad signature
    rolls back, lower rollback version refused, `explicit_buy` bumps the OTP
    rollback thermometer. Slots 1–3 stay free for key rotation (revocation via
    `KEY_INVALID`).
  - Status (2026-10-26): tooling done, lock board tests open. `fw/keys/test-signing.pem`
    (secp256k1, committed). The runner (and so `ota-push.py`) signs when
    `PICOCELL_SIGNING_KEY` is set and then checks the image with
    `tools/verify-image.py` (block loop, last IMAGE_DEF, SHA-256 over the load map and
    the block up to HASH_DEF with the TBYB bit cleared, as picotool and the ROM do;
    secp256k1 ECDSA in plain Python; key from the PEM via openssl; prints the
    BOOTKEY hash). `--features production` puts the symbol `PICOCELL_PRODUCTION` in the
    ELF: the runner refuses to seal it without a key and adds `--rollback` from
    `[package.metadata.picocell]` (1 for now; picotool's default rows 0x04e/0x051).
    `status` (`security` line), the boot log and `GatewayStats` metadata (`variant`,
    `secure_boot`, `debug`, `boot_keys`; metadata map raised to 8 entries) show the
    build and the OTP state, read only (OTP `CRITICAL` register, `BOOT_FLAGS1` by
    majority of its three rows). `tools/test-signing.py --production ELF` 11/11.
    Signed dev images on a dev board: `hil-test.py --flash --ota` 20/20 (UF2 and OTA,
    the ROM boots a signed image without secure boot as before).
  - Findings: the sealed image has two IMAGE_DEF blocks, the firmware's own (unsigned)
    and picotool's; the ROM and picotool take the last one in the loop. The hash
    covers the image type word with the TBYB bit cleared, which is why it still
    verifies after `explicit_buy` rewrites that word.
- **8d. OTP AES key**
  - Key source abstraction: dev = HMAC(chip ID), production = OTP page.
  - At boot read the key page, then soft-lock it until reset. Unwritten page (all
    zero) → no key → provisioning mode (5.4). Read and soft lock are testable on
    the dev boards, since the soft lock is gone after a reset.
  - Console command `otp-key init` (production only, refused without secure boot,
    asks for confirmation): 16 random bytes, write with ECC, read back, set the
    page locks (no bootloader/non-secure access, so `picotool` in BOOTSEL cannot
    read it; secure read-only). Lock board only.
  - No migration: boards are provisioned again (as the fw README says).
  - Status (2026-10-27): implemented; read and soft lock tested on a dev board
    (`tools/hil-test.py --flash` 16/16), `otp-key init` waits for the lock board.
    `fw/src/config_key.rs`: OTP page 20 (rows 0x500–0x53f; page 30 is picotool's
    default for encrypted boot), key in ECC rows 0–7, then a 32-bit check (SHA-256 of
    the key, first 4 bytes) in rows 8–9, written last, so an interrupted write reads
    as damaged. Production config key = HMAC-SHA-256(OTP key, "picocell-gw config
    key")[..16], so further keys can be derived later; dev key unchanged (stored dev
    configs stay readable). At boot the page is read raw (all zero → empty) and with
    ECC, then `SW_LOCK` NSEC and SEC inaccessible; a production build with an empty
    page keeps SEC readable for `otp-key init`. `otp-key init` (production, secure
    boot on, page and its LOCK1 row zero, typed `yes`): TRNG key, ECC writes, read
    back, LOCK1 = 0x3d3d3d (LOCK_S read-only, LOCK_NS and LOCK_BL inaccessible), soft
    lock, restart. Without a key the store is not opened (`commit` says so).
    `status` line `config key`, console `otp-key`, `GatewayStats` metadata
    `config_key` (`dev`/`otp`/`none`). Dev builds compile the write path out
    (`otp-key init` → error). +1 KB text.
  - Lock board tests: `otp-key init` refused with secure boot off; with it on, key
    written, `picotool otp get` of rows 0x500… refused in BOOTSEL, config stored and
    loaded after reboot, a second `init` refused.
- **8e. CA rotation** (dev boards)
  - Signed `command/ca`: ECDSA P-256 with its own config-signing key (separate
    from the boot key; the firmware already has P-256 verify via `embassy-crypto`).
    The public key is compiled into the image; a sequence number stored with the
    config blocks replays of an old CA. Writes `tls.ca1`.
  - When handshakes succeed only with ca1, ca1 becomes ca0.
  - New CAs can also come with a signed image.
  - Host tool to sign and send; test with `tools/test-broker`: issue a second CA,
    roll it out, switch the broker.
  - Status (2026-10-27): done, tested on a dev board (`tools/hil-test.py --flash --ca`
    20/20). `fw/src/ca_update.rs`: `command/ca` = sequence number (u64 LE, Unix time
    of signing by convention), certificate (DER, empty clears `tls.ca1`), ECDSA P-256
    `r || s` over SHA-256("picocell-gw ca update\0" || seq || cert). Not bound to a
    gateway (one signature for the fleet) and retained messages allowed, since
    signature and sequence number carry the protection: seq equal to the stored one →
    `current`, lower → rejected, more than a day ahead of the clock → rejected (a
    typo would block all later updates). Accepted: seq (own map item 3, survives
    `commit`, reset only by `erase`; unreadable → updates refused) then settings with
    `tls.ca1`, answer on `state/ca`, restart. A session that came up with `tls.ca1`
    (only tried after `tls.ca0` rejected the broker certificate) makes it `tls.ca0`, clears
    `tls.ca1` (old CA no longer trusted) and restarts. Public key from `build.rs`:
    `PICOCELL_CONFIG_PUBKEY` (PEM), default `fw/keys/test-config-signing.pub.pem`,
    required by production builds. `PICOCELL_CA` puts a CA into the image; installed
    into `tls.ca1` at boot when in neither slot and the build time (its sequence
    number) is above the stored one, so an old image cannot bring back a replaced CA
    (tested by hand: installed with the build time, then cleared with `ca-push.py
    --clear`). Host tool `tools/ca-push.py` (signs via openssl, `--save`/`--message`
    for reuse, `--retain`), `tools/test-broker/rotate-ca.sh issue|switch`. `status`
    line `ca update`. +7 KB text, +0.5 KB RAM.
  - Findings: rust-mqtt's first const parameter counts SUBSCRIBEs awaiting their
    SUBACK, not subscriptions; with a fourth subscription it had to go from 3 to 4
    (otherwise "publish/subscribe failed" on every connection). Mosquitto reloads the
    broker certificate on SIGHUP but keeps open connections, so the gateway sees the
    new CA on its next connection. Keeping the init future small: a second
    `Settings` copy (2 KB) across an await in `config::init` cost 9 KB in the main
    task's static future.
- **8f. Production lock procedure** (last, lock board or real production boards)
  - `tools/lock-board.py`, each step separately with a confirmation: check the
    board, boot key hash + secure boot, flash the signed image, `otp-key init`,
    provision, debug disable + glitch detector.
  - A production build goes online only after the last step (see above), so the
    procedure ends with a check that the gateway reaches the broker.
  - Write the procedure down in section 5.

## 9. Open points

### 9.1 Firmware

Done items are described in `fw/README.md` and the commit history.

- `embedded-tls`: move from the pinned git rev to the first release after 0.19.0
  once it is out; review upstream changes before bumping the rev.
- Config keys not yet implemented: `net.mac`, radio keys, `location`.
- Whether to support `command/config`.
- FUOTA test (needs ChirpStack and a device). The duty cycle keeps no reservation for
  Class A RX2 in the 869.4–869.65 MHz band, so a FUOTA burst can block RX2 for up
  to an hour.

### 9.2 Hardware and verification

- Look up LCSC numbers and stock for the new parts (3-pin terminal, TPS2116, SN74LVC1G17,
  LED, buttons).
- Schematic (hw/, KiCad 8) started: all blocks drawn, ERC clean. Footprints still
  missing: SM8S33A (DO-218AB), FCH0650 15 µH, mPCIe socket PCIE-52P52H + standoff,
  L76K VCC TVS (part to choose), supercap, V_BCKP diode (low-leakage part to choose).
  Check the terminal footprint (MSTBVA-compatible) against the DEGSON drawing and the
  Pico footprint against the W5500-EVB-Pico2 header positions.
- Check the GNSS active-antenna bias / DC block / π-match against the L76K Hardware
  Design reference circuit (drawn with the bias on the connector side of a 100 pF
  DC block).
- Mechanics before layout: enclosure / board outline (DIN rail?), positions of the
  terminal, RJ45, USB-C, LED light pipe, buttons and the two U.FL → SMA pigtails.

- Measure WM1302 3.3 V current at max TX power on the real board (datasheet: 415 mA)
  and check the 3.3 V droop with ≤ 68 µF (TPS563201 limit); try the DNP polymer
  footprint only if needed.
- Confirm the surge estimate (TVS ≤ 72 V, buck VIN ≤ 63 V) in LTspice with the
  LMR38020 model and a saturating inductor, later with a surge test.
- Check the mPCIe standoff height (3.0 mm Würth 9774030243R) against the XUNPU
  PCIE-52P52H drawing and the WM1302 outline before layout.
- Read the leakage of the Eaton PHVL-3R9H474-R from its datasheet (≤ 2 µA wanted);
  measure backup current.
- Measure the TLS handshake time on the RP2350 (P-256 in software); confirm RAM.
