Hoernchen20/picocell-gw/hw/gnss.kicad_sch

## KiCad design hw/gnss.kicad_sch (2026-10-18)

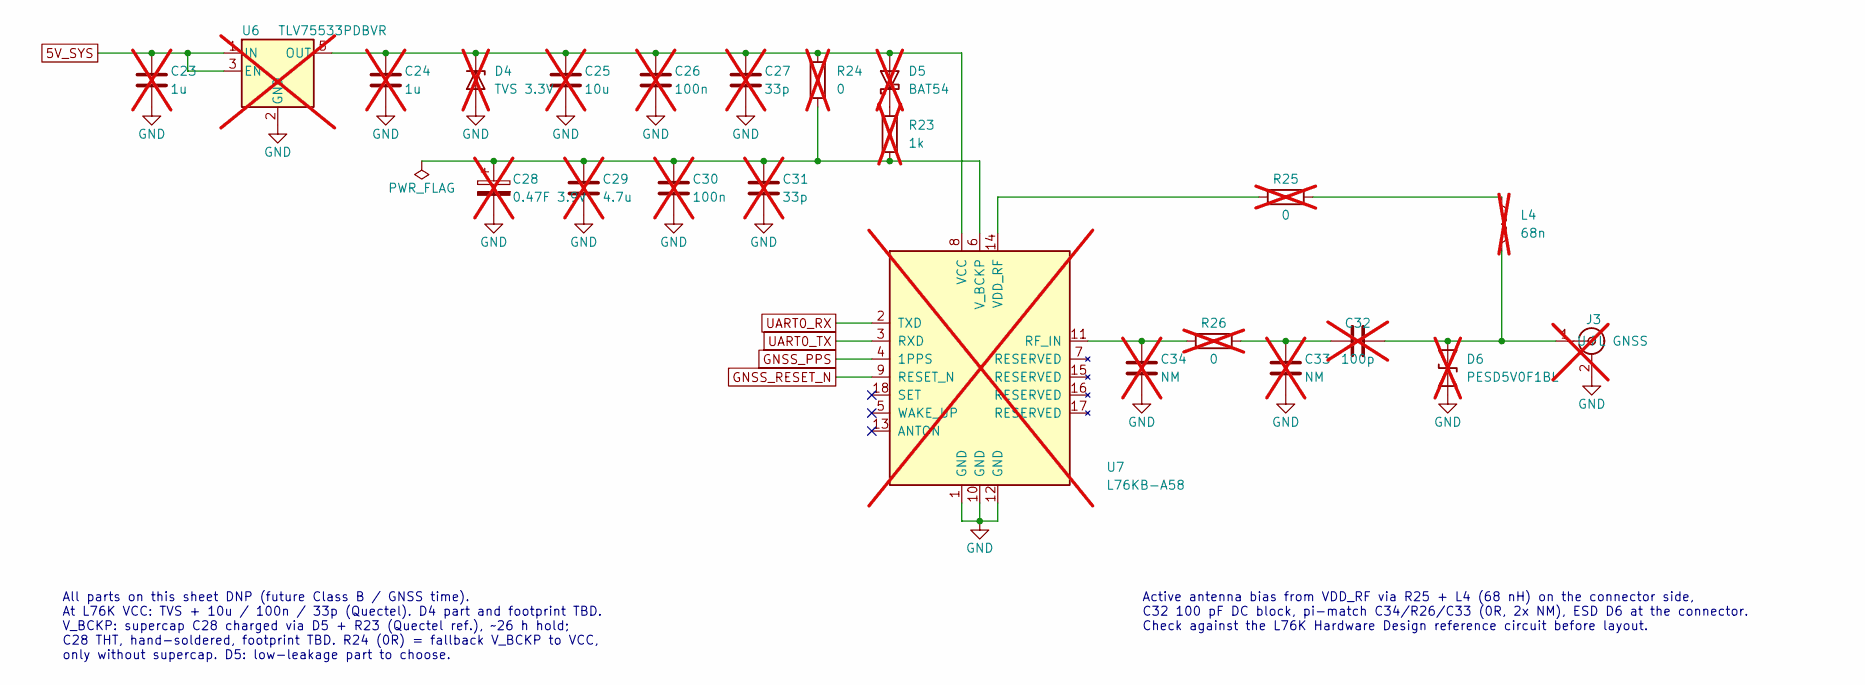
[picture p1: schematic gnss.kicad_sch]

Parts:
C23, C24: 1u; C_0603_1608Metric; not fitted
C25: 10u; C_0603_1608Metric; not fitted
C26, C30: 100n; C_0402_1005Metric; not fitted
C27, C31: 33p; C_0402_1005Metric; not fitted
C28: 0.47F 3.9V; MPN Eaton PHVL-3R9H474-R; not fitted
C29: 4.7u; C_0603_1608Metric; not fitted
C32: 100p; C_0402_1005Metric; not fitted
C33, C34: NM; C_0402_1005Metric; not fitted
D4: TVS 3.3V; not fitted
D5: BAT54; D_SOD-323; not fitted
D6: PESD5V0F1BL; D_SOD-882; LCSC C45961; not fitted
J3: U.FL GNSS; U.FL_Hirose_U.FL-R-SMT-1_Vertical; MPN BAT WIRELESS BWU.FL-IPEX1; LCSC C5137195; not fitted
L4: 68n; L_0402_1005Metric; MPN Murata LQG15HS68NJ02D; LCSC C98000; not fitted
R23: 1k; R_0603_1608Metric; not fitted
R24: 0; R_0603_1608Metric; not fitted
R25, R26: 0; R_0402_1005Metric; not fitted
U6: TLV75533PDBVR; SOT-23-5; LCSC C404027; not fitted
U7: L76KB-A58; Quectel_L76; LCSC C2916234; not fitted

Connections:
5V_SYS: C23.1, U6.1 (IN), U6.3 (EN)
GND: C23.2, C24.2, C25.2, C26.2, C27.2, C28.2, C29.2, C30.2, C31.2, C33.2, C34.2, D4.2 (A), D6.1 (A1), J3.2 (Ext), U6.2 (GND), U7.1 (GND), U7.10 (GND), U7.12 (GND)
GNSS_PPS: U7.4 (1PPS)
GNSS_RESET_N: U7.9 (RESET_N)
unnamed: C24.1, C25.1, C26.1, C27.1, D4.1 (K), D5.2 (A), R24.1, U6.5 (OUT), U7.8 (VCC)
unnamed: C28.1, C29.1, C30.1, C31.1, R23.2, R24.2, U7.6 (V_BCKP)
unnamed: C32.1, C33.1, R26.2
unnamed: C32.2, D6.2 (A2), J3.1 (In), L4.2
unnamed: C34.1, R26.1, U7.11 (RF_IN)
unnamed: D5.1 (K), R23.1
unnamed: L4.1, R25.2
unnamed: R25.1, U7.14 (VDD_RF)
UART0_RX: U7.2 (TXD)
UART0_TX: U7.3 (RXD)

Notes on the sheet:
All parts on this sheet DNP (future Class B / GNSS time). At L76K VCC: TVS + 10u / 100n / 33p (Quectel). D4 part and footprint TBD. V_BCKP: supercap C28 charged via D5 + R23 (Quectel ref.), ~26 h hold; C28 THT, hand-soldered, footprint TBD. R24 (0R) = fallback V_BCKP to VCC, only without supercap. 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
Active antenna bias from VDD_RF via R25 + L4 (68 nH) on the connector side, C32 100 pF DC block, pi-match C34/R26/C33 (0R, 2x NM), ESD D6 at the connector. Check against the L76K Hardware Design reference circuit before layout.
