Hoernchen20/picocell-gw/hw/lora.kicad_sch

## KiCad design hw/lora.kicad_sch (2026-10-23)

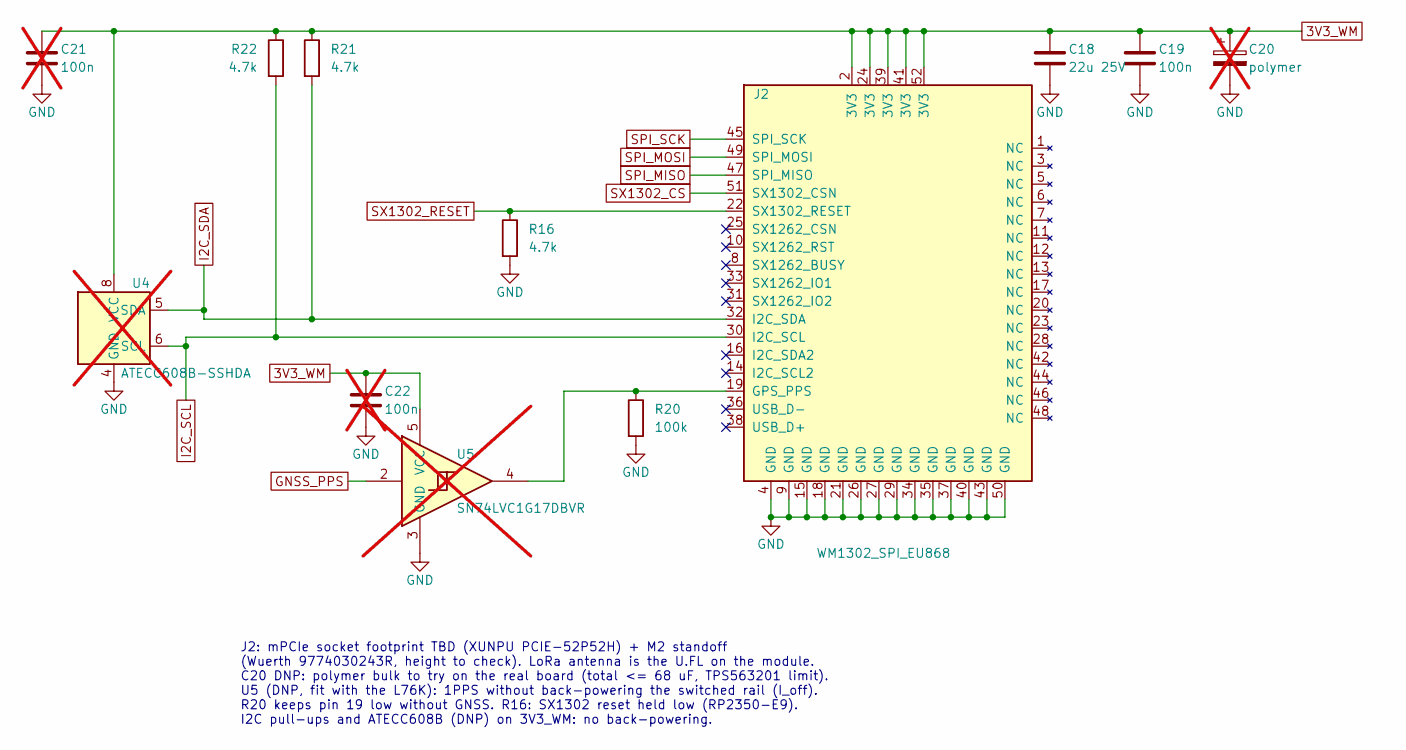
[picture p2: schematic lora.kicad_sch]

Parts:
C18: 22u 25V; C_1206_3216Metric; LCSC C12891
C19: 100n; C_0603_1608Metric
C20: polymer; not fitted
C21, C22: 100n; C_0603_1608Metric; not fitted
J2: WM1302_SPI_EU868; MPN socket XUNPU PCIE-52P52H (C266899)
R16, R21, R22: 4.7k; R_0603_1608Metric
R20: 100k; R_0603_1608Metric
U4: ATECC608B-SSHDA; SOIC-8_3.9x4.9mm_P1.27mm; LCSC C1518769; not fitted
U5: SN74LVC1G17DBVR; SOT-23-5; not fitted

Connections:
3V3_WM: C18.1, C19.1, C20.1, C21.1, C22.1, J2.2 (3V3), J2.24 (3V3), J2.39 (3V3), J2.41 (3V3), J2.52 (3V3), R21.1, R22.1, U4.8 (VCC), U5.5 (VCC)
GND: C18.2, C19.2, C20.2, C21.2, C22.2, J2.4 (GND), J2.9 (GND), J2.15 (GND), J2.18 (GND), J2.21 (GND), J2.26 (GND), J2.27 (GND), J2.29 (GND), J2.34 (GND), J2.35 (GND), J2.37 (GND), J2.40 (GND), J2.43 (GND), J2.50 (GND), R16.2, R20.2, U4.4 (GND), U5.3 (GND)
GNSS_PPS: U5.2
I2C_SCL: J2.30 (I2C_SCL), R22.2, U4.6 (SCL)
I2C_SDA: J2.32 (I2C_SDA), R21.2, U4.5 (SDA)
unnamed: J2.19 (GPS_PPS), R20.1, U5.4
SPI_MISO: J2.47 (SPI_MISO)
SPI_MOSI: J2.49 (SPI_MOSI)
SPI_SCK: J2.45 (SPI_SCK)
SX1302_CS: J2.51 (SX1302_CSN)
SX1302_RESET: J2.22 (SX1302_RESET), R16.1

Notes on the sheet:
J2: mPCIe socket footprint TBD (XUNPU PCIE-52P52H) + M2 standoff (Wuerth 9774030243R, height to check). LoRa antenna is the U.FL on the module. C20 DNP: polymer bulk to try on the real board (total <= 68 uF, TPS563201 limit). U5 (DNP, fit with the L76K): 1PPS without back-powering the switched rail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
