Hoernchen20/picocell-gw/hw/mcu.kicad_sch

## KiCad design hw/mcu.kicad_sch (2026-10-23)

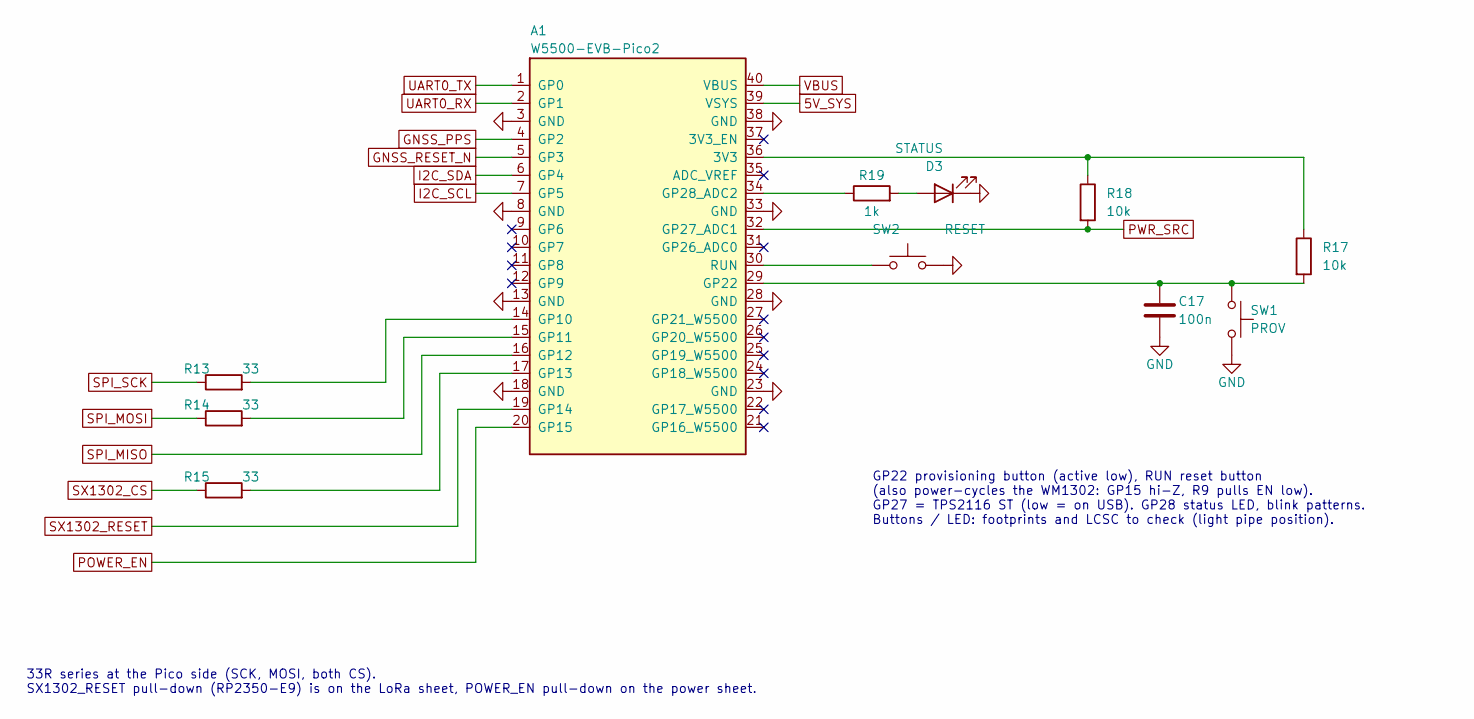
[picture p3: schematic mcu.kicad_sch]

Parts:
A1: W5500-EVB-Pico2; RaspberryPi_Pico_Common_THT; MPN 2x HCTL PM254-1-20-Z-8.5 (C2897383)
C17: 100n; C_0603_1608Metric
D3: STATUS; LED_0603_1608Metric
R13, R14, R15: 33; R_0603_1608Metric
R17, R18: 10k; R_0603_1608Metric
R19: 1k; R_0603_1608Metric
SW1: PROV; SW_Push_1P1T_XKB_TS-1187A
SW2: RESET; SW_Push_1P1T_XKB_TS-1187A

Connections:
5V_SYS: A1.39 (VSYS)
GND: A1.3 (GND), A1.8 (GND), A1.13 (GND), A1.18 (GND), A1.23 (GND), A1.28 (GND), A1.33 (GND), A1.38 (GND), C17.2, D3.1 (K), SW1.2, SW2.2
GNSS_PPS: A1.4 (GP2)
GNSS_RESET_N: A1.5 (GP3)
I2C_SCL: A1.7 (GP5)
I2C_SDA: A1.6 (GP4)
unnamed: A1.14 (GP10), R13.2
unnamed: A1.15 (GP11), R14.2
unnamed: A1.17 (GP13), R15.2
unnamed: A1.29 (GP22), C17.1, R17.2, SW1.1
unnamed: A1.30 (RUN), SW2.1
unnamed: A1.34 (GP28_ADC2), R19.1
unnamed: A1.36 (3V3), R17.1, R18.1
unnamed: D3.2 (A), R19.2
POWER_EN: A1.20 (GP15)
PWR_SRC: A1.32 (GP27_ADC1), R18.2
SPI_MISO: A1.16 (GP12)
SPI_MOSI: R14.1
SPI_SCK: R13.1
SX1302_CS: R15.1
SX1302_RESET: A1.19 (GP14)
UART0_RX: A1.2 (GP1)
UART0_TX: A1.1 (GP0)
VBUS: A1.40 (VBUS)

Notes on the sheet:
33R series at the Pico side (SCK, MOSI, both CS). SX1302_RESET pull-down (RP2350-E9) is on the LoRa sheet, POWER_EN pull-down on the power sheet.
GP22 provisioning button (active low), RUN reset button (also power-cycles the WM1302: GP15 hi-Z, R9 pulls EN low). GP27 = TPS2116 ST (low = on USB). GP28 status LED, blink patterns. Buttons / LED: footprints and LCSC to check (light pipe position).
