Hoernchen20/picocell-gw/hw/power_in.kicad_sch

## KiCad design hw/power_in.kicad_sch (2026-10-18)

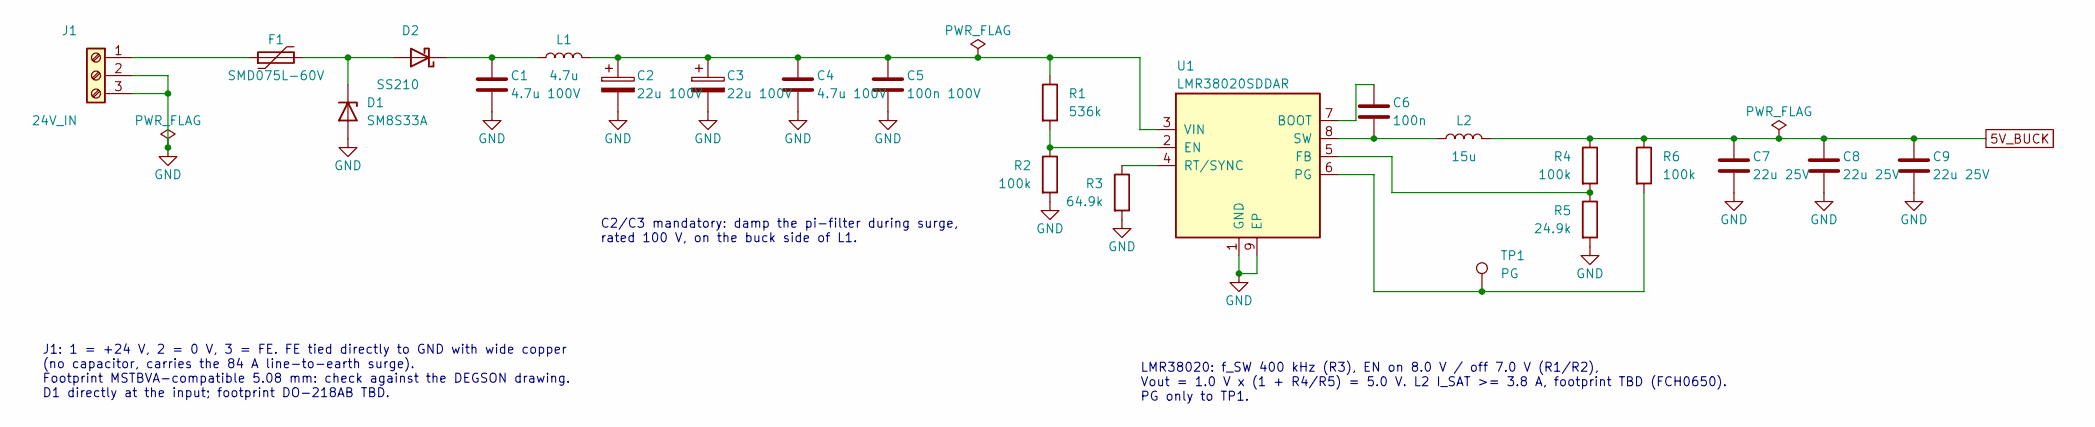
[picture p4: schematic power_in.kicad_sch]

Parts:
C1, C4: 4.7u 100V; C_1210_3225Metric; LCSC C2840282
C2, C3: 22u 100V; CP_Elec_8x10; MPN Panasonic EEEFK2A220P; LCSC C178570
C5: 100n 100V; C_0603_1608Metric; LCSC C15725
C6: 100n; C_0603_1608Metric
C7, C8, C9: 22u 25V; C_1206_3216Metric; LCSC C12891
D1: SM8S33A; MPN Vishay SM8S33AHE3_A/I; LCSC C335622
D2: SS210; D_SMA; LCSC C14996
F1: SMD075L-60V; Fuse_2920_7451Metric; LCSC C2833621
J1: 24V_IN; PhoenixContact_MSTBVA_2,5_3-G-5,08_1x03_P5.08mm_Vertical; MPN DEGSON 15EDGVC-5.08-03P-14-00AH
L1: 4.7u; L_Sunlord_SWPA4030S; LCSC C57269
L2: 15u; MPN FANGCHENG FCH0650-150M; LCSC C20415538
R1: 536k; R_0603_1608Metric
R2, R4, R6: 100k; R_0603_1608Metric
R3: 64.9k; R_0603_1608Metric
R5: 24.9k; R_0603_1608Metric
TP1: PG; TestPoint_Pad_D1.0mm
U1: LMR38020SDDAR; SOIC-8-1EP_3.9x4.9mm_P1.27mm_EP2.41x3.3mm_ThermalVias; LCSC C3192337

Connections:
5V_BUCK: C7.1, C8.1, C9.1, L2.2, R4.1, R6.1
GND: C1.2, C2.2, C3.2, C4.2, C5.2, C7.2, C8.2, C9.2, D1.2 (A), J1.2, J1.3, R2.2, R3.2, R5.2, U1.1 (GND), U1.9 (EP)
unnamed: C1.1, D2.1 (K), L1.1
unnamed: C2.1, C3.1, C4.1, C5.1, L1.2, R1.1, U1.3 (VIN)
unnamed: C6.1, U1.7 (BOOT)
unnamed: C6.2, L2.1, U1.8 (SW)
unnamed: D1.1 (K), D2.2 (A), F1.2
unnamed: F1.1, J1.1
unnamed: R1.2, R2.1, U1.2 (EN)
unnamed: R3.1, U1.4 (RT/SYNC)
unnamed: R4.2, R5.1, U1.5 (FB)
unnamed: R6.2, TP1.1, U1.6 (PG)

Notes on the sheet:
J1: 1 = +24 V, 2 = 0 V, 3 = FE. FE tied directly to GND with wide copper (no capacitor, carries the 84 A line-to-earth surge). Footprint MSTBVA-compatible 5.08 mm: check against the DEGSON drawing. D1 directly at the input; footprint DO-218AB TBD.
C2/C3 mandatory: damp the pi-filter during surge, rated 100 V, on the buck side of L1.
LMR38020: f_SW 400 kHz (R3), EN on 8.0 V / off 7.0 V (R1/R2), Vout = 1.0 V x (1 + R4/R5) = 5.0 V. L2 I_SAT >= 3.8 A, footprint TBD (FCH0650). PG only to TP1.
