Hoernchen20/picocell-gw/hw/power_rails.kicad_sch

## KiCad design hw/power_rails.kicad_sch (2026-10-18)

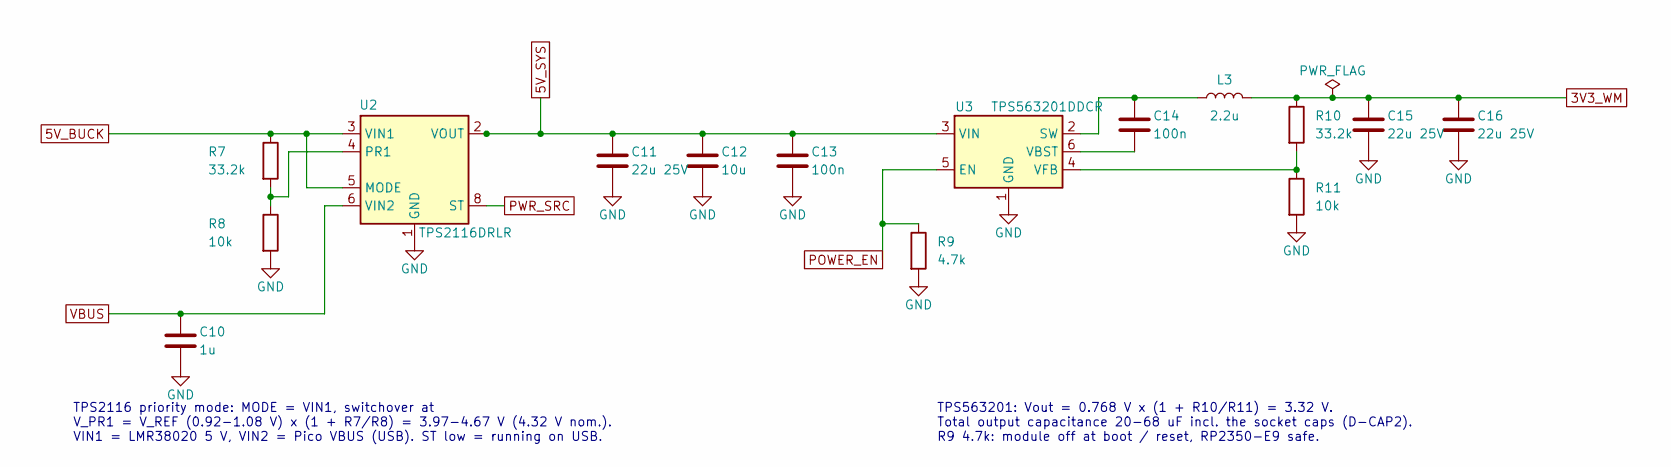
[picture p5: schematic power_rails.kicad_sch]

Parts:
C10: 1u; C_0603_1608Metric
C11, C15, C16: 22u 25V; C_1206_3216Metric; LCSC C12891
C12: 10u; C_0603_1608Metric
C13, C14: 100n; C_0603_1608Metric
L3: 2.2u; L_Sunlord_SWPA4030S; LCSC C36409
R7, R10: 33.2k; R_0603_1608Metric
R8, R11: 10k; R_0603_1608Metric
R9: 4.7k; R_0603_1608Metric
U2: TPS2116DRLR; SOT-583-8
U3: TPS563201DDCR; SOT-23-6; LCSC C116592

Connections:
3V3_WM: C15.1, C16.1, L3.2, R10.1
5V_BUCK: R7.1, U2.3 (VIN1), U2.5 (MODE)
5V_SYS: C11.1, C12.1, C13.1, U2.2 (VOUT), U2.7 (VOUT), U3.3 (VIN)
GND: C10.2, C11.2, C12.2, C13.2, C15.2, C16.2, R8.2, R9.2, R11.2, U2.1 (GND), U3.1 (GND)
unnamed: C14.1, L3.1, U3.2 (SW)
unnamed: C14.2, U3.6 (VBST)
unnamed: R7.2, R8.1, U2.4 (PR1)
unnamed: R10.2, R11.1, U3.4 (VFB)
POWER_EN: R9.1, U3.5 (EN)
PWR_SRC: U2.8 (ST)
VBUS: C10.1, U2.6 (VIN2)

Notes on the sheet:
TPS2116 priority mode: MODE = VIN1, switchover at V_PR1 = V_REF (0.92-1.08 V) x (1 + R7/R8) = 3.97-4.67 V (4.32 V nom.). VIN1 = LMR38020 5 V, VIN2 = Pico VBUS (USB). ST low = running on USB.
TPS563201: Vout = 0.768 V x (1 + R10/R11) = 3.32 V. Total output capacitance 20-68 uF incl. the socket caps (D-CAP2). R9 4.7k: module off at boot / reset, RP2350-E9 safe.
