Hoernchen20/picocell-gw/(commit log)

2026-10-17 sketch: add 24 V DC industrial supply and Quectel L76K GNSS
2026-10-17 sketch: verify WM1302 and L76K pinout/power against datasheets
    - SX1262 (not SX1261) incl. BUSY/DIO1 lines
    - WM1302 has no POWER_EN pin; GP15 switches the 3.3 V buck EN
    - full mPCIe pin table, 1PPS on pin 19
    - dedicated LDO for L76K, V_BCKP/RESET_N/antenna notes
    - input range 9-32 V, SMCJ33A, LMR36015, ~0.5 A @ 5 V budget
2026-10-17 sketch: decide firmware stack, surge target and GNSS backup supply
    - embedded-tls with webpki + P-256 broker cert (no RSA/alloc)
    - micropb for ChirpStack protos (no alloc)
    - boot ROM A/B partitions with TBYB instead of embassy-boot-rp
    - L76K baud probing, supercap on V_BCKP
    - surge target EN 61000-6-2 (0.5 kV) for the 24 V port
2026-10-17 sketch: close open points (surge, V_BCKP, TLS, protobuf, OTA)
    - Surge: SMCJ33A fails the 2 ohm line-to-line test; switch to SM8S33A
    and the 80 V LMR38020 buck, add buck layout/input notes.
    - L76K V_BCKP: 0.47 F supercap (~26 h hold at 8 uA).
    - TLS: host test against Mosquitto; use rustpki (webpki needs ring and
    ignores intermediates), wrap it with a chain-pinning verifier because
    basicConstraints is not checked, MFL 4096 with 2 x 4352 B buffers.
    - Protobuf: micropb generation of ChirpStack gw protos verified with
    protoc interop, capacities and struct sizes recorded.
    - OTA: embassy-rp ROM bindings checked, TBYB ImageDef, flash_op reads,
    partition table 2 x 988 KB + 64 KB config.
    Co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
2026-10-17 sketch: check surge levels against EN IEC 61000-6-2:2019
    DC power port: ±0.5 kV line-to-line, ±1 kV line-to-earth (was 0.5 kV);
    2 Ω / 12 Ω source impedance. Note applicability (long distance lines,
    DC distribution network) and line-to-earth current path.
2026-10-17 sketch: pick JLCPCB parts, rework input protection, check surge clamp
    - Input protection: PTC + SM8S33A crowbar + series Schottky instead of P-FET
    - Simulated surge: TVS <= 72 V, buck VIN <= 63 V; damping electrolytic required
    - LMR38020 and TPS563201 component values from datasheets
    - WM1302 decoupling limited to TPS563201 20-68 uF range
    - L76K LDO: TLV75533P (active discharge)
    - BOM table with LCSC numbers and stock
    - Supercap not stocked at JLCPCB: THT candidate
2026-10-18 sketch: add USB power mux, PPS buffer, LED/buttons, FE terminal
    Decide the open points before starting the schematic: TPS2116 mux for
    USB-only provisioning, DNP SN74LVC1G17 PPS buffer, I2C pull-ups on the
    WM1302 rail, SPI series resistors, E9 pull-downs, 3-pin terminal with
    FE, status LED, provisioning and reset buttons. Drop PoE for rev 1.
2026-10-18 hw: start KiCad 8 schematic
    Hierarchical schematic with one sheet per block (input protection and
    24 V buck, power mux and WM1302 rail, Pico, WM1302 socket, L76K) and a
    project symbol library for the Pico module, WM1302, L76K and LMR38020.
    ERC clean. Record the TPS2116 PR1 divider and the remaining footprint
    and GNSS antenna checks in sketch.md.
    [gnss.kicad_sch, lora.kicad_sch, mcu.kicad_sch, picocell-gw.kicad_sch, power_in.kicad_sch, power_rails.kicad_sch]
2026-10-18 hw: draw schematic with wires instead of net labels
    Connections inside a sheet are now wires; global labels remain only for
    nets that cross sheets, GND stays on power symbols. Pico pins 9-20 are
    fanned out so the 33R series resistors fit in one column, and the
    SX1302_RESET pull-down moves to the LoRa sheet. Netlist unchanged, ERC
    clean. Project file now carries KiCad's default settings.
    [gnss.kicad_sch, lora.kicad_sch, mcu.kicad_sch, picocell-gw.kicad_sch, power_in.kicad_sch, power_rails.kicad_sch]
2026-10-19 sketch: static IP config, hosts table and DNS resolver, derived MAC
    Target networks have no DHCP and no DNS. Add static IPv4 config, a hosts
    table checked before optional DNS servers, and a MAC derived from the
    RP2350 chip ID. Drop the idea of an I2C config EEPROM for v1.
2026-10-23 sketch, hw: drop SX1262 (LBT/spectral scan), use WM1302 variant without it
    LBT is not required in EU868 (ETSI duty cycle applies), so the cheaper
    WM1302 SPI variant without the SX1262 is enough. Remove the SX1262 nets
    and the CS series resistor R12, mark GP6-GP9 and mPCIe pins 8/10/25/33
    as no-connect.
    [lora.kicad_sch, mcu.kicad_sch]
2026-10-23 sketch: pin embedded-tls main, choose rust-mqtt 0.6
    embedded-tls 0.19.0 accepts a handshake without server authentication
    (upstream #215) and its async read is not cancel-safe; both are fixed
    on main only, so pin a reviewed rev. rustpki on main trusts only a
    broker certificate signed directly by the root: drop the intermediate
    and the chain-pinning wrapper.
    rust-mqtt 0.6 (MQTT 5, no alloc) passed the host test against
    Mosquitto incl. Last Will, ACL refusal and select! cancellation.
    Full-size TLS read buffer instead of relying on max_fragment_length.
2026-10-23 fw, tools: firmware skeleton with TLS/MQTT session, test broker
    fw/: Embassy firmware for the W5500-EVB-Pico2: Ethernet (DHCP or
    static), TLS 1.3 (embedded-tls main, rustpki, fail-closed clock, TRNG
    as embassy-crypto RNG) and MQTT 5 (rust-mqtt) with retained ConnState,
    Last Will, command/down subscription and reconnect backoff. MAC and
    placeholder gateway ID derived from the RP2350 chip ID; log output on
    USB CDC; settings are build-time values until the config store exists.
    tools/: Mosquitto test broker setup, the rust-mqtt/embedded-tls host
    regression test and an ELF to UF2 converter for the RP2350.
    [build.rs, config.rs, ids.rs, main.rs, mqtt.rs, tls.rs]
2026-10-23 fw: drop uplinks queued during an outage, log build time
    Uplinks are not buffered across broker outages (sketch.md section 6):
    their RX windows have passed. Clear the queue once the session is up
    and log how many were dropped. The status line now shows the build
    time so it is visible which firmware is running.
    Tested on hardware: cable unplug and broker restart (backoff up to 60 s).
    [main.rs, mqtt.rs]
2026-10-24 fw: SNTP clock and hosts/DNS resolver
    The wall clock now comes from SNTP instead of the build time, so the
    fail-closed certificate check (sketch.md section 6) is active: MQTT
    waits for the first time sync. Up to three servers, median of the
    replies, random cookie as origin timestamp, results before the build
    time rejected; hourly resync.
    Names resolve like "hosts: files dns" (section 3.4): IP literal, hosts
    table, DNS (static servers, then DHCP), last known address. Queries use
    a random ID and source port and must match the question.
    DNS and SNTP packet code lives in fw/wire without I/O, with host tests.
    PICOCELL_MQTT_ADDR is replaced by PICOCELL_HOSTS; new PICOCELL_DNS and
    PICOCELL_NTP.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
    [build.rs, clock.rs, config.rs, lib.rs, main.rs, mqtt.rs, resolve.rs]
2026-10-24 fw: ChirpStack protobuf messages (ConnState, UplinkFrame, GatewayStats)
    - fw/chirpstack: types generated with micropb from the ChirpStack v4.20.0
    gw/common protos (vendored protoc, unused mesh/ZMQ/exec messages and
    deprecated *_legacy fields skipped), encoders for ConnState, UplinkFrame
    and GatewayStats; host tests decode the output with protoc.
    - state/conn: protobuf ConnState ONLINE, Last Will OFFLINE.
    - event/stats: GatewayStats on connect and every 30 s (counters zero until
    there is a radio, metadata firmware/build).
    - Test uplink is now an UplinkFrame with a proprietary payload and made-up
    LoRa metadata, 1 MHz counter in the context.
    - tools/pb-decode.sh decodes a message from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
    [build.rs, clock.rs, lib.rs, main.rs, mqtt.rs]
2026-10-24 fw: JIT downlink queue, DownlinkFrame handling and DownlinkTxAck
    - fw/jit: host-tested downlink queue modelled on the Lora-net jitqueue.c
    (8 frames sorted by count_us, wrap-safe, too late below 42.5 ms lead, too
    early beyond 60 s, collisions with start delay and margins, Immediately in
    the first free slot) and LoRa time on air.
    - chirpstack: DownlinkFrame decoding (LoRa item parameters, delay timing with
    the 4-byte uplink context) and DownlinkTxAck encoding, checked against
    protoc in host tests.
    - Firmware: DownlinkFrame items are tried in order; the first accepted one is
    OK, the rest IGNORED; ack published on event/ack. TX_FREQ, TX_POWER,
    GPS_UNLOCKED and INTERNAL_ERROR for wh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
    [downlink.rs, lib.rs, main.rs, mqtt.rs]
2026-10-24 fw: EU868 duty cycle, sub-band power limits, Class C test
    - jit::duty: ETSI EN 300 220 sub-bands, sliding 1 h window in one-minute
    buckets per band, checked before queuing (DUTY_CYCLE_OVERFLOW); a frame
    must fit in one sub-band (TX_FREQ) and stay below its power (16 dBm EIRP,
    27 dBm in 869.4-869.65 MHz, else TX_POWER).
    - GatewayStats carries duty_cycle_stats (load per band, ETSI regulation).
    - JIT queue: the frame handed to the radio keeps its airtime blocked until
    the TX task reports it done; before, an "immediately" frame could be
    placed on top of a frame already on air.
    - tools/test-classc.sh: Class C downlinks with immediately timing, one
    status per frame; test-downlink.sh pr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
2026-10-24 fw: USB console with log history and commands
    Own logger and CDC-ACM console replace embassy-usb-logger, so log output
    and commands share the USB-C port:
    - 8 KB RAM log history (fw/console, host-tested ring buffer and line
    editor), replayed whenever a terminal opens the port, then live output
    above the redrawn input line. Any control request counts as an open
    once the port is quiet for 300 ms: DTR alone is unreliable because
    minicom clears HUPCL, so DTR stays high after close.
    - Commands: status, log, log off|warn|info (RAM only), log show [n],
    reboot, bootsel. Each ends with "ok" or "error: ..." for scripts.
    - Boot message with version, gateway ID and MAC; network up/down logged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
    [console.rs, lib.rs, main.rs, mqtt.rs]
2026-10-24 fw: encrypted config store and USB provisioning
    The build-time PICOCELL_* settings are replaced by a config stored in the
    flash config partition (0x1F0000, 64 KB, behind the image, so flashing keeps
    it): one sequential-storage item with format byte, random nonce, AES-128-GCM
    over the settings and tag, read back after writing. The key is a dev key
    derived from the chip ID until the OTP key (step 8).
    - fw/settings (host-tested): keys from sketch section 7 in use today, value
    checks on set and on load, stored form (key=value text + two CA slots),
    PEM input.
    - Without a complete config the gateway stays offline in provisioning mode.
    - Console: show (secrets as ***, CAs as size + SHA-256), s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
    [build.rs, config.rs, console.rs, lib.rs, main.rs, mqtt.rs, resolve.rs]
2026-10-25 fw: remote password change over MQTT
    Two-phase change per sketch.md 5.2. The raw new password on
    command/credentials (retained messages refused, subscribed with
    retain-as-published) is stored as a second encrypted map item next to
    the config. The next connection uses it: accepted by the broker, it
    becomes mqtt.password and the gateway restarts; refused ("bad username
    or password"), attempts alternate with the stored one, and when that is
    accepted the new one is dropped. The staged password survives a restart.
    Answers go to state/credentials as text (stored, committed, rejected:
    <reason>); status shows a staged password; a console commit supersedes it.
    Password rule is now 1-64 printable ASC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
    [config.rs, console.rs, lib.rs, mqtt.rs]
2026-10-25 tools: USB-console hardware-in-the-loop test
    tools/hil-test.py tests a board on USB and Ethernet against the test
    broker using only the USB console: console commands and errors, status
    fields, provisioning with gateway.conf (net.hosts pointing at this
    machine, gateway registered with the broker) or a reboot with
    --no-provision, MQTT connection, ConnState, GatewayStats, UplinkFrame,
    the Class A and Class C downlink cases from fw/README.md with their
    expected statuses, and one "TX (no radio)" log line per downlink acked
    OK. --flash builds and flashes via "bootsel", --erase deletes the config
    at the end. Prints PASS/FAIL per check and exits with the number of
    failures.
    It refuses to start whil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
2026-10-25 sketch: plan for step 8 (secure boot, OTP key, A/B OTA, CA rotation)
    Dev and production builds, milestones 8a-8f, and the decisions so far:
    OTA in chunks over MQTT, a separate P-256 key for signed CA messages,
    no OTP writes on the current boards, full console access with a to-do
    for a password-protected console login.
2026-10-25 fw: partition table, own IMAGE_DEF with TBYB, flash_op config access
    Step 8a (sketch.md 8.1):
    - fw/partition-table.json: 8 KB table, slots A and B (988 KB, B linked
    to A), 64 KB config at 0x1F0000 readable only by secure code. Loaded
    with picotool; copying the table UF2 to the BOOTSEL drive is ignored.
    - Own IMAGE_DEF (embassy-rp imagedef-none): secure ARM exe with the
    TBYB flag. Until OTA, the firmware calls explicit_buy at boot when
    the ROM reports a buy pending.
    - fw/src/flash.rs: embedded-storage driver on ROM flash_op (storage
    addresses, secure level) in a critical section; the config store uses
    it, since with the table XIP maps only the running slot. The
    embassy-rp flash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
2026-10-25 fw: A/B firmware update over MQTT with TBYB trial and watchdog
    Milestone 8b (sketch.md 8.1). The image arrives on command/ota (begin with
    size and SHA-256, then 4 KB chunks), goes into the slot that is not running
    and is answered on state/ota. The first sector is written last, after the
    SHA-256 matched, so a partial image never boots. Then a FLASH_UPDATE reboot
    into the new slot.
    An OTA trial (marked in watchdog SCRATCH0) is bought after the broker
    connection and subscriptions, else it reboots after 300 s and the old
    image boots; UF2 trials are still bought at boot. The firmware now runs
    the watchdog (8 s, own task), replacing the ROM's 16.7 s trial watchdog.
    tools/ota-push.py sends an ima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
    [boot.rs, console.rs, flash.rs, main.rs, mqtt.rs, ota.rs]
2026-10-26 fw: image signing tooling, production build, OTP security state
    Step 8c (sketch.md 8.1), the parts that need no OTP writes:
    - fw/keys/test-signing.pem: secp256k1 test key, committed as dev
    material; the production key stays separate and offline.
    - The runner (and so ota-push.py) signs with picotool seal --sign when
    PICOCELL_SIGNING_KEY is set and checks the result against that key.
    - --features production marks the ELF (symbol PICOCELL_PRODUCTION): the
    runner refuses to seal it without a key and adds the rollback version
    from [package.metadata.picocell]. Dev images keep none.
    - tools/verify-image.py: independent check of a sealed image (last
    IMAGE_DEF in the block loop, SHA-256 ov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
2026-10-27 fw: OTP config key with soft lock, otp-key console command
    Dev builds keep the chip-ID key; production builds derive it from a
    random key in OTP page 20, written once by "otp-key init" (secure boot
    required, then permanent page locks). Both builds read the page at boot
    and soft-lock it until reset.
    [config.rs, config_key.rs, console.rs, main.rs, mqtt.rs]
2026-10-27 fw: fix OTA chunk length, airtime overflow, retained downlinks
    From the firmware security review:
    - ota: refuse a last chunk longer than 4096 bytes (it panicked at offset 0
    and wrote past the one erased sector elsewhere).
    - jit: lora_airtime_us returns None for a preamble above 65535 symbols, so a
    huge value can no longer overflow and undercount the duty cycle.
    - mqtt: ignore retained command/down messages, which would be sent again on
    every connection (subscribed with retain-as-published to see live ones).
    - main: seed the network stack from the TRNG instead of the ROSC.
    - main: no test uplinks in production builds.
    [downlink.rs, lib.rs, main.rs, mqtt.rs, ota.rs]
2026-10-27 fw: console login with a PBKDF2 password hash
    console.password in the encrypted config (PBKDF2-HMAC-SHA256, random salt,
    required in production builds) locks the console: only help, status, log,
    login, logout and erase work before login. Logout on port close, logout and
    10 minutes idle; wrong passwords wait 3 s doubling to 60 s. erase stays open
    as the recovery for a forgotten password, since it deletes the MQTT password
    with the rest.
    provision.py hashes the password on the host and logs in on a locked
    console; hil-test.py provisions a test password and checks the lock.
    [console.rs, lib.rs, login.rs, main.rs]
2026-10-27 fw: production builds stay offline on a board that is not locked
    A production image now goes online only with secure boot on, a boot key
    that is not revoked and debug disabled in OTP; otherwise it keeps the
    console only, so a debugger or an unsigned image cannot get at the config
    key and the MQTT password of a gateway in the field. Provisioning still
    works before the last lock step. The boot log, the console banner and
    status name the missing step.
    [boot.rs, console.rs, main.rs, mqtt.rs]
2026-10-30 fw: WM1302 power, reset and SX1302 SPI probe
    SPI1 on GP10-13, SX1302 reset on GP14, POWER_EN on GP15. At boot the
    module is power-cycled and the SX1302 version and page register are
    checked; the radio console command repeats this. The EUI read returns a
    constant until the HAL clock setup is ported.
    [console.rs, main.rs, radio.rs]
2026-10-30 fw: sx1302_hal on core 1, EU868 reception logged
    Semtech sx1302_hal V2.1.0 (unmodified, fw/sx1302/hal) built with cc and
    newlib-nano; fw/sx1302/shim replaces its Linux SPI, I2C, clock and printf
    code with Rust callbacks and stubs the USB backends. newlib's mem*/str*
    are renamed in a copy of libc_nano so they do not replace
    compiler_builtins' for Rust code (newlib's memcpy reads unaligned words,
    which fault on the USB buffer memory).
    The HAL blocks, so core 1 owns the WM1302: power cycle, SPI probe,
    lgw_start with the EU868 plan of global_conf.json.sx1250.EU868 (needs the
    STTS751 on I2C0 GP4/GP5), then lgw_receive every 10 ms; frames are logged,
    not yet forwarded. Flash writes park core 1 in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
    [build.rs, console.rs, flash.rs, lib.rs, main.rs, pc.h, pc_compat.h]
2026-10-30 fw: forward received frames as UplinkFrame, downlinks on the SX1302 counter
    Core 1 hands frames with a valid CRC to uplink_task on core 0, which publishes
    them on event/up with the SX1302 count_us as context and the fetch time as
    gw_time; FSK frames are logged and dropped. GatewayStats carries the RX
    counters. After each poll core 1 reads the SX1302 counter, and
    downlink::count_us extrapolates from it with the RP2350 timer (the RP2350
    timer while the concentrator is not running). Test uplinks only while the
    radio is not running, for hil-test.py and test-downlink.sh on a bare board.
    Tested on the desk: 868.1 MHz SF7 frame published, context matches count_us.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
2026-10-30 fw: send downlinks through lgw_send, TX gain table, reset check in the probe
    tx_task hands each frame to core 1 through a one-frame mailbox; core 1 loads
    it between polls (lgw_send, timestamped), polls lgw_status from its computed
    end until TX_FREE and reports back, and only then does the queue release the
    airtime. A frame loaded after its trigger time, or still on air 100 ms after
    its end, is aborted. The TX gain LUT of global_conf.json.sx1250.EU868
    (12-27 dBm) goes to lgw_txgain_setconf; frames below 12 dBm get TX_POWER, as
    the HAL would send them at 12 dBm, and payloads above 255 bytes are refused.
    The queue now reserves handover and lgw_send time before each frame, so
    back-to-back frame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
    [console.rs, downlink.rs, lib.rs, pc.h, radio.rs, shim.c]
2026-10-31 fw: TX power cap on USB power, SPI at 7.5 MHz, shorter lgw_send reservation
    On USB VBUS (TPS2116 ST low on GP27, read per frame) downlinks go out at
    14 dBm at most instead of being refused; the pull-down makes a board without
    the connector PCB count as on USB. The SX1302 SPI runs at 7.5 MHz instead of
    2 MHz, which brings lgw_send from 1.94 ms to 875-888 µs on the desk, so the
    queue reserves 1.5 ms for it and back-to-back frames start 6.5 ms apart.
    [downlink.rs, lib.rs, main.rs, radio.rs]
2026-11-01 fw: keep the SX1302 EUI in the config partition, reset reason in the boot log
    The EUI of the last concentrator start is stored (written only when it
    changes), so a board whose module does not start keeps its gateway ID and
    stays reachable for OTA. The chip ID is only the fallback without a stored
    EUI. The boot line now says what reset the chip.
    [boot.rs, config.rs, console.rs, ids.rs, main.rs]
2026-11-01 fw: status LED patterns, restart the radio when the SX1302 counter stalls
    The LED on GP28 is on while booting, blinks at 2 Hz offline, 1/2/3 times
    every 2 s for no link / no broker / no concentrator, and is on with an off
    flash per frame when online.
    Core 1 checks that the SX1302 counter advances with the RP2350 timer; after
    10 polls in a row that it does not (open SPI lines), it restarts the module,
    so a lost module shows up as "no answer" instead of a running radio that
    reads garbage.
    [led.rs, main.rs, mqtt.rs, radio.rs]
2026-11-01 fw: MQTT reconnect handling: SUBACK and PINGRESP checks, backoff jitter
    A refused subscription ends the session, the OTA trial is bought once all
    SUBACKs are granted. A ping without PINGRESP by the next one ends the
    session (20-40 s instead of the 90 s TCP timeout). The backoff resets only
    after a session of at least 60 s and gets up to 25 % jitter.
    hil-test.py: accept the ID source after the gateway ID in status.
    [mqtt.rs]
2026-11-01 fw: core 1 stall reset, radio retry with backoff, MQTT ends on link down
    [boot.rs, console.rs, mqtt.rs, radio.rs]
2026-11-01 fw: reset the TCP connection when an MQTT session ends; refused SUBACK test
    Dropping the embassy-net socket sent nothing, so the broker kept a dead
    session and held back the will until the keep-alive ran out. session()
    now keeps the socket, runs TLS and MQTT on a reference and aborts it
    afterwards. tools/test-broker/refuse-suback.py stands in for Mosquitto
    (whose acl_file grants every subscription) to test the refused-SUBACK path.
    [mqtt.rs]
2026-11-01 fw: TRNG stall reset; record panics and core 0 hangs across the reset
    embassy-rp's blocking TRNG read waits for TRNG_BUSY to clear before it
    checks the errors, but after four failed autocorrelation tests the TRNG
    stops and stays busy: core 0 spun there inside a critical section until
    the watchdog reset the chip (9 of 10 reflash rounds on one day). The TRNG
    is now read with the PAC: an autocorrelation error or 10 ms without data
    resets it, the wait holds only a lock between the cores, and the sample
    count is 100 instead of 25.
    src/crash.rs replaces panic-halt: a panic, or core 0 not reaching the
    watchdog task for 5 s (TIMER0 alarm 3 routed to core 0's NMI), stores
    the reason (message, or the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
    [boot.rs, crash.rs, main.rs, tls.rs]
2026-11-01 fw: switch the CA slot only when the broker certificate is rejected
    Any failed TLS handshake made the next attempt use the other CA slot, so
    whoever could disrupt handshakes (reset, alert, garbage) forced the
    fallback to tls.ca1. FailClosed now flags a certificate its CA does not
    accept, and only that switches; other failures keep the slot.
    Tested on the board: hil-test.py --ca rotation and back pass; a fake
    server answering the ClientHello by closing, a fatal alert or garbage
    gave six handshake failures without a switch to tls.ca1.
    [mqtt.rs, tls.rs]
2026-11-03 tools: ChirpStack v4 test setup in Docker with the test broker
    ChirpStack 4.20 with Postgres, Redis and Mosquitto 2.1.2 via docker compose.
    Mosquitto uses the CA, certificate, password file and ACL from
    tools/test-broker/out/, so the gateway config and the test-broker scripts
    stay unchanged. The EU868 region file is ChirpStack's template, which matches
    the gateway's channel plan. README: gateway and ABP device (LoraWAN-Mapper)
    setup. setup.sh creates the ACL with mode 600 (Mosquitto 2.1 warns about
    world-readable ACL files).
